nothinx/RECELL-AI/README.md

# 🔋 RECELL-AI

> **Mesin Klasifikasi Otomatis Baterai Bekas (*Second-Life*) Standar Industri**
> Sistem grading multimodal (Computer Vision + Time-Series Electrochemistry) untuk kompetisi **KIWIE 2026**.








---

## 🖥️ Tampilan Dashboard

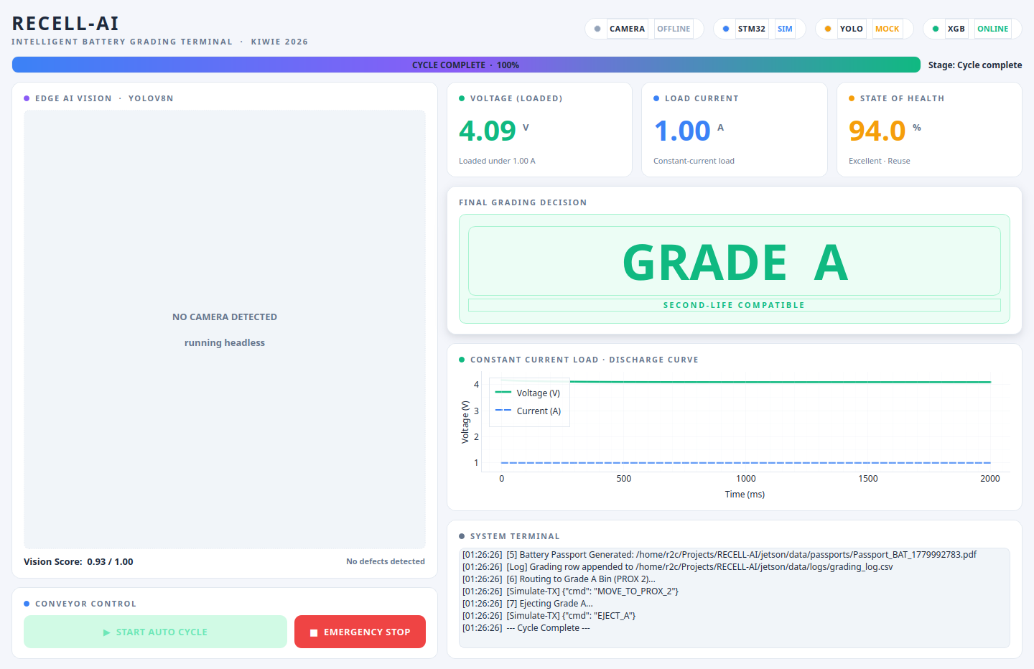
[picture p1: docs/images/dashboard_complete.png]
Dashboard — hasil cycle grading


<details>
<summary>Lihat state lain (STANDBY & TESTING)</summary>

| STANDBY (sebelum cycle) | TESTING (saat constant-current load) |
| :---: | :---: |
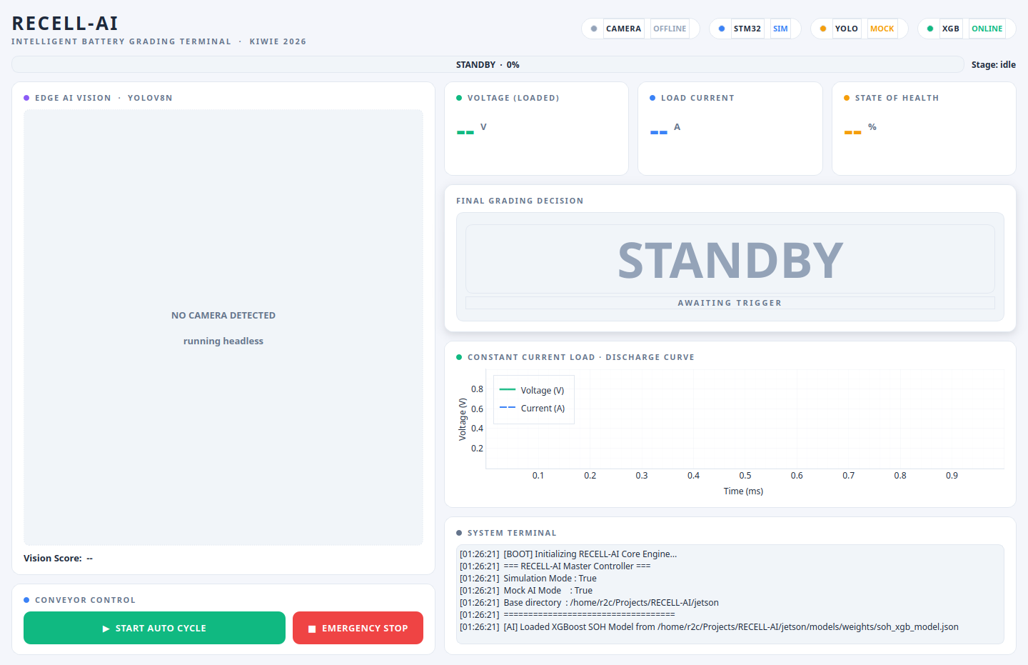
[picture p2: docs/images/dashboard_standby.png]
Standby
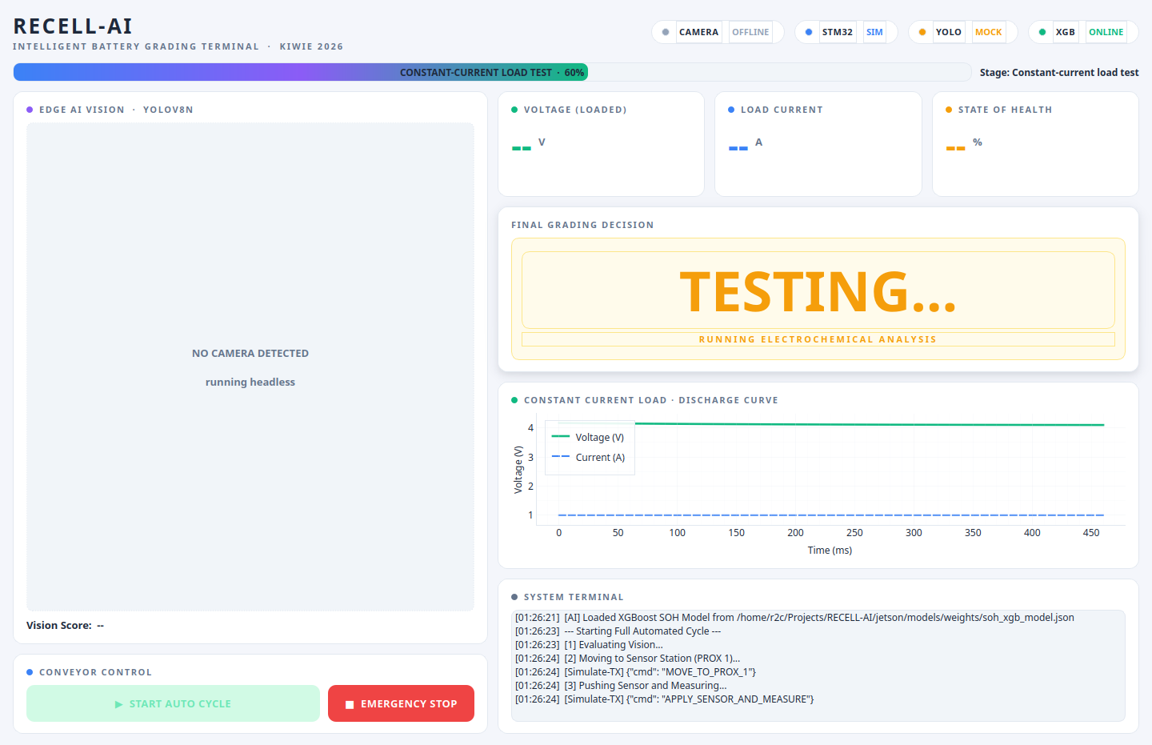
[picture p3: docs/images/dashboard_running.png]
Testing
|  |  |
</details>

---

## 📂 Struktur Workspace

| Modul | Deskripsi | Status |
| :--- | :--- | :--- |
| [**🧠 `jetson/`**](./jetson) | Otak AI multimodal (YOLOv8n + XGBoost), dashboard PyQt5, orkestrasi cycle | `Software siap` |
| [**👁️ `carollus/`**](./carollus) | Modul Computer Vision self-contained: classifier YOLOv8n-cls 4 kelas (KARAT/KOSONG/SEHAT/SOBEK) + skrip evaluasi/deploy | `Aktif` |
| [**🦾 `firmware/`**](./firmware) | Firmware STM32F411: ADC 12-bit, kontrol stepper & konveyor, payload JSON | `Siap di-flash` |
| [**🔬 `research/`**](./research) | Whitepaper, arsitektur AI, plot matplotlib untuk publikasi | `Aktif` |
| [**📖 `docs/`**](./docs) | Panduan deploy, cheatsheet rumus SoH, gambar dashboard | `Aktif` |

---

## 🧠 Arsitektur Multimodal

```
┌──────────────────┐     ┌──────────────────┐     ┌──────────────────┐
│ YOLOv8n-cls (Vis)│     │  XGBoost  (SOH)  │     │  STM32  (Sensor) │
│  best_cls.pt     │     │  soh_xgb.json    │     │  INA226+MLX90614 │
│ KOSONG / KARAT / │     │  v_drop, Rint, ΔT│     │  JSON @115200 8N1│
│ SEHAT / SOBEK    │     │                  │     │                  │
└────────┬─────────┘     └────────┬─────────┘     └────────┬─────────┘
         │                        │                        │
         ▼                        ▼                        ▼
        Vision Score         SoH Prediksi (%)        Telemetri Real-time
                  \           |           /
                   \          |          /
                    ▼         ▼         ▼
            ┌────────────────────────────────┐
            │   Grading Decision (A / B / R) │
            │   • Vision < 0.4 OR SOH < 60 → R│
            │   • Vision > 0.8 AND SOH > 80 → A│
            │   • selainnya → B               │
            └────────────────┬───────────────┘
                             ▼
            ┌────────────────────────────────┐
            │  Battery Passport (PDF + QR    │
            │  bertanda tangan HMAC-SHA256)  │
            │  grading_log.csv + discharge   │
            └────────────────────────────────┘
```

---

## 🚀 Quick Start

### 1. Install dependency
```bash
# Recommended (di Jetson Orin Nano): ikuti panduan resmi NVIDIA untuk torch + opencv
# Di PC dev (CPU-only):
pip install -r jetson/requirements.txt
pip install torch torchvision --index-url https://download.pytorch.org/whl/cpu
```

### 2. Pastikan model siap
```text
jetson/models/weights/
├── best_cls.pt          # YOLOv8n-cls (KOSONG / KARAT / SEHAT / SOBEK) — dipakai utama
├── best.pt              # YOLOv8n detect (fallback bila best_cls.pt tidak ada)
└── soh_xgb_model.json   # XGBoost SoH regressor (NASA-trained)
```

> `main.py` memilih model **classification** (`best_cls.*`) lebih dulu; deteksi objek (`best.*`) hanya fallback bila classifier tidak ada.

### 3. Jalankan dashboard
```bash
cd jetson/src

# Mode 1 — Sim + YOLO real + kamera laptop
python3 ui_dashboard.py --sim

# Mode 2 — Sim + tanpa YOLO/kamera (paling cepat, GUI saja)
python3 ui_dashboard.py --sim --mock-ai

# Mode 3 — Produksi (STM32 di /dev/ttyUSB0)
python3 ui_dashboard.py
```

### 4. (Jetson saja) Kompilasi YOLO ke TensorRT
```bash
# Di Jetson Orin Nano — 2× lebih cepat dengan FP16
yolo export model=jetson/models/weights/best_cls.pt format=engine half=True imgsz=224
# main.py akan otomatis prefer best_cls.engine di atas best_cls.pt
```

---

## 🔬 AI Vision Classes

Model **classifier** `best_cls.pt` (YOLOv8n-cls, 224×224) mengambil **Top-1** dari 4 kelas:

| Label | Arti | Vision Score | Catatan |
| :---: | :--- | :--- | :--- |
| **`KOSONG`** | Slot kosong / tak ada baterai | — (*gate*) | Frame diabaikan, bukan sinyal grading |
| **`SEHAT`** | Baterai bersih | `1.0` | Kandidat Grade A |
| **`KARAT`** | Korosi/karat di kutub | `0.5` | Dihitung setelah lolos persistence (≥ 3 frame) |
| **`SOBEK`** | Wrapper plastik sobek | `0.0` | Defect berat → cenderung Grade R |

> **Catatan** — Ini **klasifikasi citra**, bukan deteksi objek, jadi **tidak ada bounding box** di feed; model hanya menjawab kondisi dominan (Top-1) per frame. Defect (`KARAT`/`SOBEK`) baru dihitung setelah persisten ≥ 3 frame untuk menyaring false positive. Modul vision mandiri ada di [`carollus/`](./carollus).

---

## ⚡ AI Electrical (SoH)

XGBoost regressor dilatih pada **NASA Prognostics Battery Dataset**. Fitur input:

| Fitur | Sumber | Rentang Khas |
| :--- | :--- | :--- |
| `v_drop` (V) | `v_resting − v_loaded` | 0.05 – 0.50 |
| `internal_r` (Ω) | `v_drop / current_load` | 0.05 – 0.50 |
| `temp_delta` (°C) | `temp_post − temp_pre` | 0.5 – 8.0 |

Output: prediksi SoH (%) dengan clamp `[0, 100]`. Fallback rule-based aktif jika model gagal di-load.

---

## 🔌 Pinout Hardware (STM32F411CEU6)

### Aktuator & Konveyor (Motor Driver BTS7960)
| Pin | Fungsi | Deskripsi |
| :---: | :--- | :--- |
| `PA5` | `CONVEYOR_EN` | Enable BTS7960 |
| `PA1` | `CONVEYOR_RPWM` | PWM maju |
| `PA2` | `CONVEYOR_LPWM` | PWM mundur |
| `PB0` / `PB9` / `PA7` | `STP_DRAIN_*` | Stepper Drain Station (DIR/PUL/EN) |
| `PA3` / `PA8` / `PA6` | `STP_SORT_*` | Stepper Sorting Station (DIR/PUL/EN) |

### Sensor, Limit Switch & Pengukuran
| Pin | Fungsi | Deskripsi |
| :---: | :--- | :--- |
| `PB15` / `PA4` | `LIMIT_DRAIN` / `LIMIT_SORTING` | Batas mekanik stepper |
| `PB14` / `PB12` / `PB13` | `IR_DRAIN` / `IR_SORTING` / `IR_BACKUP` | Sensor IR baterai |
| `PB5` | `EMERGENCY` | Tombol Emergency Stop |
| `PB1` | `DAC_EN` | Enable Constant-Current Load (DAC MCP4725) |
| `PB7` / `PB6` | `I2C SDA` / `SCL` | Bus untuk INA226 (V/I), MLX90614 (suhu), MCP4725 (DAC) |

---

## 🔄 Cycle Otomatis (7 Langkah)

```
[1] Evaluasi Vision (capture frame, klasifikasi YOLO)
[2] Konveyor → PROX 1 (Sensor Station)
[3] Push sensor + Constant-Current Load Test (~2s discharge curve)
[4] Hitung Grade (A / B / R) dari vision_score + SoH
[5] Generate Battery Passport (PDF + QR bertanda tangan HMAC-SHA256)
[6] Routing:
    - Grade A → PROX 2 → Eject ke bin A
    - Grade B/R → END_OF_CONVEYOR → bin reject
[7] Cycle Complete + log CSV (grading_log + discharge_curve)
```

Emergency Stop dapat memutus cycle di langkah manapun (set `abort_cycle` flag, putus semua wait loop).

---

## 📊 Output Per Cycle

| File | Path | Isi |
| :--- | :--- | :--- |
| Battery Passport | `jetson/data/passports/Passport_<ID>.pdf` | Sertifikat per-baterai: ID, grade, foto, V/I/SoH + QR bertanda tangan HMAC-SHA256 |
| Grading log | `jetson/data/logs/grading_log.csv` | 1 baris per cycle: semua metrik agregat + ground truth |
| Discharge curve | `jetson/data/logs/discharge_curve.csv` | Time-series 20 ms cadence: t_ms, voltage, current, temp |

`battery_id` shared antar 3 file, jadi kurva discharge bisa di-join balik ke grade-nya untuk analisa offline.

---

## 🔐 Battery Passport Bertanda Tangan (Anti-Pemalsuan)

Setiap Battery Passport membawa **QR bertanda tangan kriptografis** agar sertifikat tidak bisa dipalsukan — semua **100% offline**, hanya memakai stdlib Python (`hmac`, `hashlib`, `secrets`), tanpa dependency berat.

**Cara kerja:**
1. Field uji disusun jadi payload kanonik berurutan tetap:
   `RC1|id|grade|soh|v_drop|internal_r|date` (presisi tiap field dikunci agar reproducible).
2. Payload ditandatangani **HMAC-SHA256** dengan kunci rahasia **per-alat**.
3. QR berisi `<payload>~<signature>`. Mengubah **satu field pun** membuat tanda tangan tidak cocok.

**Kunci penandatangan** (`jetson/config/passport_key.txt`):
- Auto-generate acak (64 hex) saat pertama kali dipakai, unik per unit.
- **RAHASIA** — sudah masuk `.gitignore`, jangan pernah di-commit. Backup terpisah.

**Verifikasi sebuah QR (offline):**
```bash
python jetson/scripts/verify_passport.py "<isi_string_QR>"
# → cetak VALID / INVALID + field terurai
# → exit code 0 (VALID) / 1 (INVALID) — gampang dipakai di skrip
```

Verifier tetap menampilkan isi yang *diklaim* meski tanda tangan gagal, sekaligus menandainya **INVALID** — jadi pemeriksa bisa lihat data palsunya.

> Modul: [`jetson/src/passport_auth.py`](./jetson/src/passport_auth.py) (sign/verify) · [`jetson/scripts/verify_passport.py`](./jetson/scripts/verify_passport.py) (CLI verifier)

---

## 🔁 Protokol Sinkronisasi Firmware ↔ GUI

Jetson dan STM32 bicara lewat **newline-delimited JSON** over USB-CDC @ **115200 8N1**. Kontrak ini bersifat **kanonik** — kedua sisi harus sepakat soal nama command, status, dan field. Sebuah regression test (`tests/test_protocol_sync.py`) memastikan tak ada satu sisi yang me-*rename* tanpa sisi lain ikut.

### Arah Jetson → STM32 (Command)
Paket dikirim `send_command(cmd, params)` → `{"cmd": "<NAMA>", ...params}\n`.

| Command | Aksi di STM32 |
| :--- | :--- |
| `RESET` | Homing semua stepper ke limit switch, reset state |
| `MOVE_TO_PROX_1` | Konveyor jalan sampai baterai di Sensor Station |
| `APPLY_SENSOR_AND_MEASURE` | Push probe + Constant-Current Load Test → stream kurva discharge |
| `MOVE_TO_PROX_2` | Konveyor jalan ke titik eject Grade A |
| `EJECT_A` | Stepper sorting dorong baterai ke bin A |
| `MOVE_TO_END` | Konveyor jalan ke ujung (bin reject B/R) |
| `STOP_CONVEYOR` | Hentikan konveyor |

### Arah STM32 → Jetson (Status)
Firmware memancarkan `{"status": "<NAMA>", ...field}\n`.

| Status | Dipakai Jetson? | Arti |
| :--- | :---: | :--- |
| `BOOT_OK` | — | Firmware siap setelah power-on |
| `AT_PROX_1` / `AT_PROX_2` | ✅ | Baterai sampai di Sensor / titik eject |
| `DISCHARGE_SAMPLE` | ✅ | Satu sampel kurva discharge (streaming ~20 ms) |
| `MEASUREMENT_DONE` | ✅ | Load test selesai, kirim agregat akhir |
| `EJECTED_A` / `DROPPED_B` | ✅ | Routing fisik selesai (bin A / bin reject) |
| `EMERGENCY_STOP` | ✅ | Tombol E-Stop ditekan → abort cycle |
| `STEP_TIMEOUT` | ✅ | Stepper tak capai limit dalam waktu wajar (fault) |
| `STOPPED` / `RESET_OK` | — | Ack untuk `STOP_CONVEYOR` / `RESET` |

### Skema Field JSON
| Pesan | Field |
| :--- | :--- |
| `MEASUREMENT_DONE` | `volt`, `curr`, `v_resting`, `temp_pre`, `temp_post`, `temp_delta` |
| `DISCHARGE_SAMPLE` | `t_ms`, `volt`, `curr`, `temp` |

> **Jaga kontrak tetap sinkron** — jalankan test sebelum mengubah protokol:
> ```bash
> python tests/test_protocol_sync.py     # tanpa pytest pun bisa (blok __main__)
> ```
> Test ini scan `RECELL_STM32.ino`, `main.py`, dan `ui_dashboard.py`; gagal kalau ada command/status/field yang tidak cocok di kedua sisi.

---

## 🛠️ Stack Teknologi

### 🖥️ Jetson Orin Nano
- **Python 3.10+**, **PyQt5** + **pyqtgraph** (HMI light theme yang dipoles)
- **YOLOv8n** (Ultralytics) → ekspor TensorRT FP16 untuk produksi
- **XGBoost** Regressor 2.x
- **FPDF** untuk Battery Passport, **SQLAlchemy/CSV** untuk log

### 🦾 STM32 BlackPill (F411CEU6)
- **Arduino IDE + STM32duino Core**
- ADC 12-bit native + **oversampling N=50** (noise reduction)
- USB-CDC Serial @ **115200 8N1**, payload JSON

---

## 🧪 Status Verifikasi

| Komponen | Bisa diuji tanpa hardware? | Status |
| :--- | :---: | :--- |
| Dashboard GUI (semua state) | ✅ | Terverifikasi via smoke-test 3-stage |
| YOLO load + inferensi webcam | ✅ | Terverifikasi (classify 4 kelas: KOSONG/KARAT/SEHAT/SOBEK) |
| XGBoost SoH prediksi | ⚠️ | Load OK, akurasi perlu validasi pada baterai nyata |
| Battery Passport PDF | ✅ | PDF tergenerasi end-to-end |
| Tanda tangan & verifikasi QR passport | ✅ | Sign/verify HMAC-SHA256 ter-cover unit test (`tests/test_passport_auth.py`) |
| CSV grading + discharge log | ✅ | Schema lengkap, sample tersimpan benar |
| Emergency Stop full abort | ⚠️ | Logic ada, validasi di lab dengan STM32 |
| Komunikasi serial STM32 | ❌ | Butuh hardware |
| Konveyor + stepper motor | ❌ | Butuh hardware |
| Persistence threshold defects | ⚠️ | Logic ada, validasi dengan kamera + baterai nyata |

---

## 📚 Dokumentasi Tambahan

- 📖 [**DEPLOY_GUIDE_RECELL**](./docs/DEPLOY_GUIDE_RECELL.md) — Setup Jetson, flash STM32, SSH
- 📐 [**Cheatsheet Rumus SOH**](./docs/Cheatsheet_Rumus_SOH.md) — Penjabaran algoritma elektrokimia
- 🤖 [**AI Training Guideline**](./jetson/AI_TRAINING_GUIDELINE.md) — Pipeline training YOLO + XGBoost
- 🗂️ [**KONTEKS.md**](./KONTEKS.md) — Master AI handover document

---

## 👨‍💻 Tim

**Amadeo Wisesa** — *System Architect & AI Engineer*

> Dikembangkan untuk RECELL-AI · KIWIE 2026 Edition · Indonesia 🇮🇩
