nothinx/RECELL-AI/research/paper_visuals/poster_data/discharge_curve.csv

battery_id | t_ms | voltage | current | temp
BAT_001 | 0 | 4.0976 | 1.006 | 24.45
BAT_001 | 20 | 4.0914 | 0.9977 | 24.42
BAT_001 | 40 | 4.0811 | 0.9986 | 24.44
BAT_001 | 60 | 4.0752 | 1.0063 | 24.5
BAT_001 | 80 | 4.0703 | 0.9937 | 24.45
BAT_001 | 100 | 4.0605 | 0.9972 | 24.53
BAT_001 | 120 | 4.0599 | 1.0009 | 24.51
BAT_001 | 140 | 4.0532 | 0.9937 | 24.46
BAT_001 | 160 | 4.0482 | 0.9915 | 24.5
BAT_001 | 180 | 4.0417 | 1.0024 | 24.5
BAT_001 | 200 | 4.0439 | 1.0037 | 24.61
BAT_001 | 220 | 4.0412 | 1.0021 | 24.5
BAT_001 | 240 | 4.037 | 0.9935 | 24.58
BAT_001 | 260 | 4.0366 | 1.0027 | 24.59
BAT_001 | 280 | 4.0337 | 1.0048 | 24.55
BAT_001 | 300 | 4.0309 | 0.9995 | 24.5
BAT_001 | 320 | 4.027 | 1.0019 | 24.56
BAT_001 | 340 | 4.0252 | 1.0047 | 24.61
BAT_001 | 360 | 4.0243 | 1.0033 | 24.64
BAT_001 | 380 | 4.0233 | 0.9983 | 24.62
BAT_001 | 400 | 4.0206 | 0.9933 | 24.6
BAT_001 | 420 | 4.0181 | 1.0027 | 24.68
BAT_001 | 440 | 4.0189 | 1.0044 | 24.64
BAT_001 | 460 | 4.0173 | 0.9963 | 24.68
BAT_001 | 480 | 4.0198 | 0.9996 | 24.63
BAT_001 | 500 | 4.0194 | 0.9971 | 24.72
BAT_001 | 520 | 4.0184 | 0.9995 | 24.73
BAT_001 | 540 | 4.0137 | 1.0027 | 24.67
BAT_001 | 560 | 4.0097 | 0.998 | 24.68
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
