nothinx/RECELL-AI/research/paper_visuals/poster_data/grading_log.csv

timestamp | battery_id | cycle_time_s | v_resting | v_loaded | v_drop | current_load | internal_r | temp_pre | temp_post | temp_delta | soh_predicted | vision_score | defects_detected | grade_predicted | grade_ground_truth | passport_pdf
2026-05-28T09:00:00 | BAT_001 | 20.98 | 4.0969 | 4.0126 | 0.0843 | 1.0 | 0.0843 | 24.43 | 25.48 | 1.05 | 80.47 | 0.881 | none | A | A | data/passports/BAT_001.pdf
2026-05-28T09:00:22 | BAT_002 | 18.79 | 4.1147 | 4.035 | 0.0797 | 1.0 | 0.0797 | 24.04 | 24.93 | 0.89 | 87.21 | 0.803 | none | A | A | data/passports/BAT_002.pdf
2026-05-28T09:00:44 | BAT_003 | 20.41 | 4.101 | 3.9879 | 0.1132 | 1.0 | 0.1132 | 24.62 | 25.96 | 1.34 | 79.44 | 0.572 | dent | B | B | data/passports/BAT_003.pdf
2026-05-28T09:01:06 | BAT_004 | 20.12 | 4.1124 | 3.9838 | 0.1285 | 1.0 | 0.1285 | 25.13 | 26.2 | 1.07 | 84.41 | 0.748 | rust | B | B | data/passports/BAT_004.pdf
2026-05-28T09:01:28 | BAT_005 | 19.43 | 3.9883 | 3.7665 | 0.2218 | 1.0 | 0.2218 | 25.78 | 28.15 | 2.37 | 54.65 | 0.306 | rust | R | R | data/passports/BAT_005.pdf
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
