nothinx/RECELL-AI/carollus/sample_images/KARAT_sample.jpg

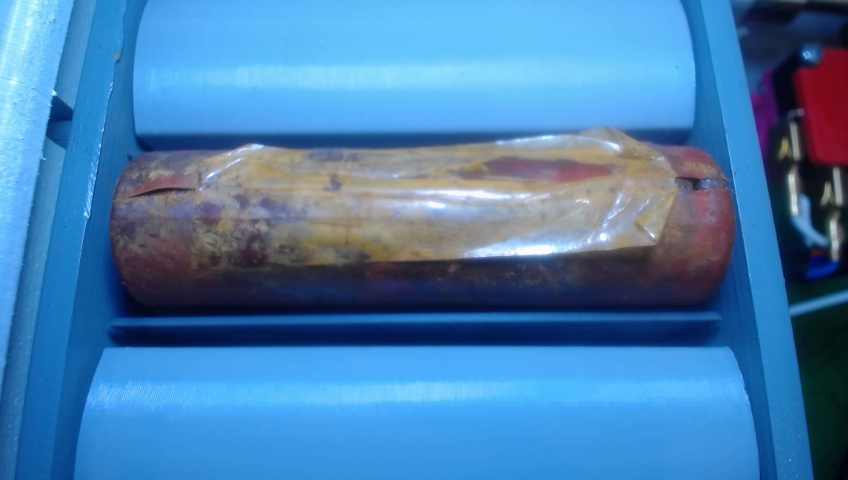
carollus/sample_images/KARAT_sample.jpg
