nothinx/RECELL-AI/carollus/sample_images/KOSONG_sample.jpg

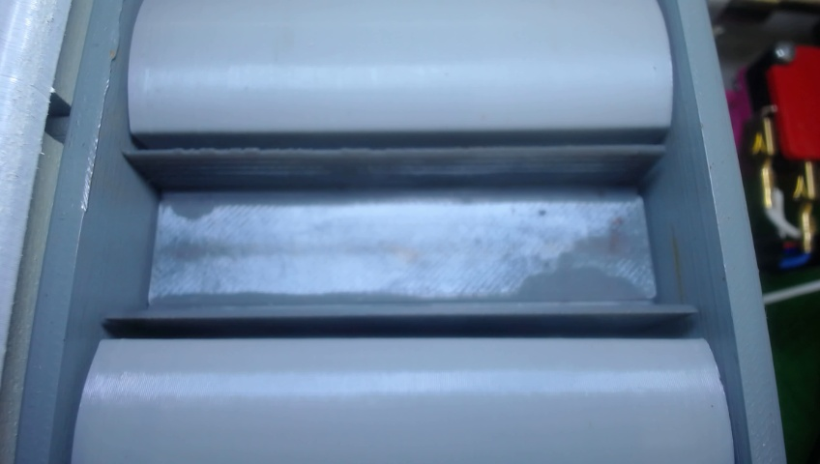
carollus/sample_images/KOSONG_sample.jpg
