nothinx/RECELL-AI/carollus/sample_images/SOBEK_sample.jpg

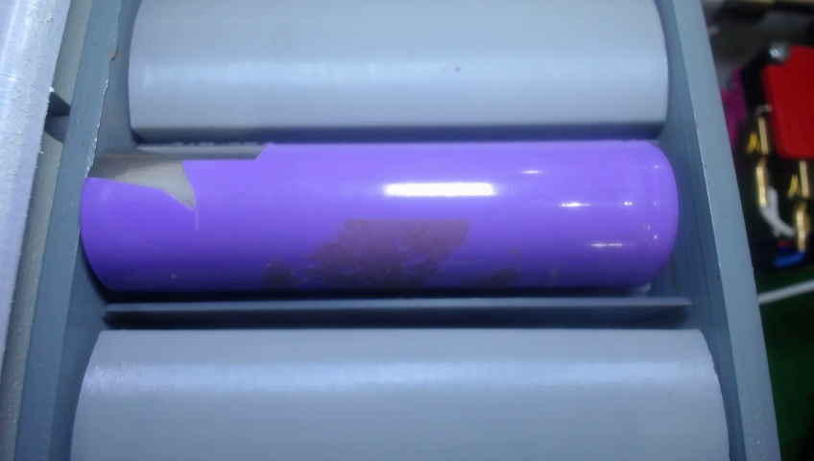
carollus/sample_images/SOBEK_sample.jpg
