nothinx/RECELL-AI/research/paper_visuals/output/01_grade_distribution.png

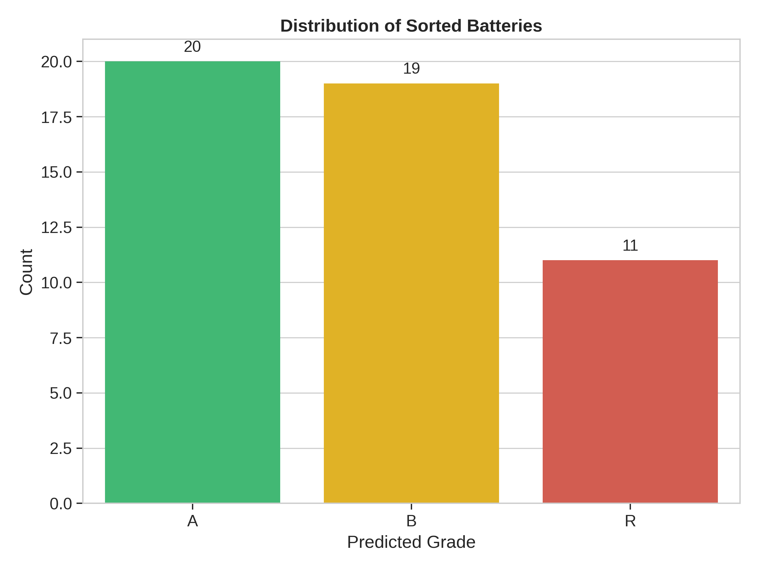
research/paper_visuals/output/01_grade_distribution.png
