nothinx/RECELL-AI/research/paper_visuals/output/02_ai_fusion_scatter.png

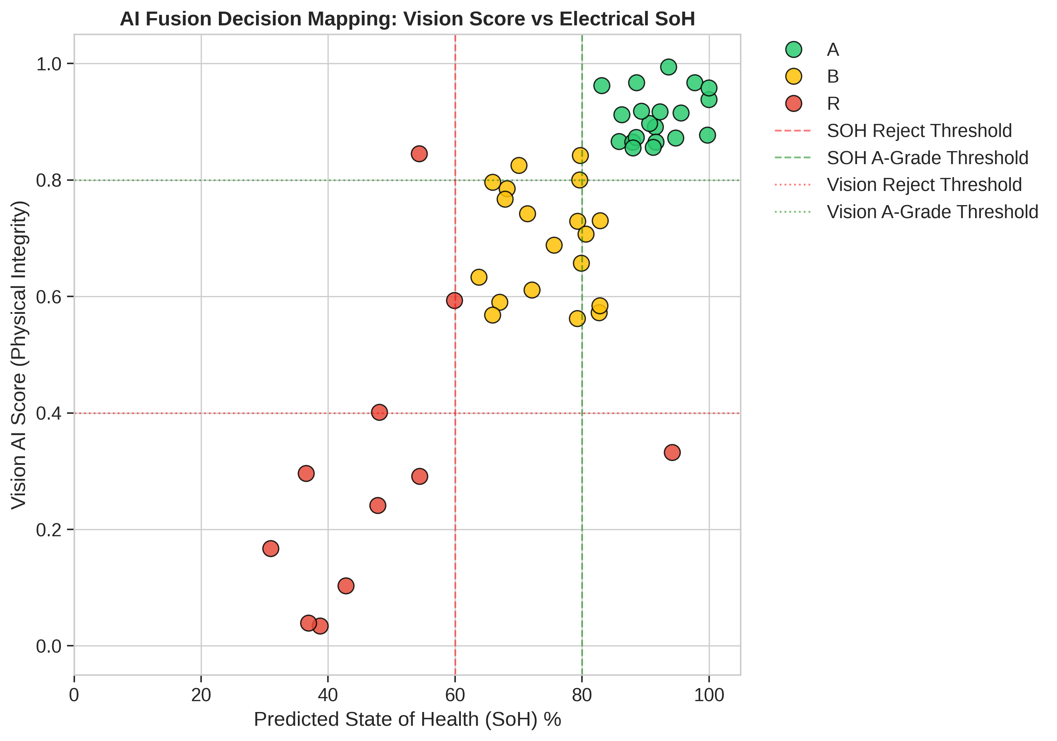
research/paper_visuals/output/02_ai_fusion_scatter.png
