nothinx/RECELL-AI/research/paper_visuals/output/03_discharge_curve.png

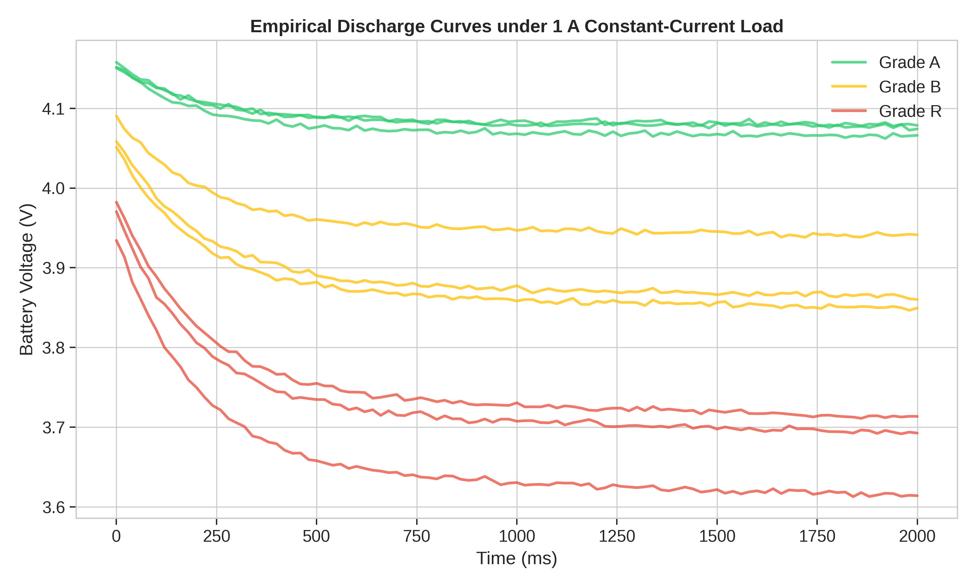
research/paper_visuals/output/03_discharge_curve.png
