nothinx/RECELL-AI/research/paper_visuals/output/04_confusion_matrix.png

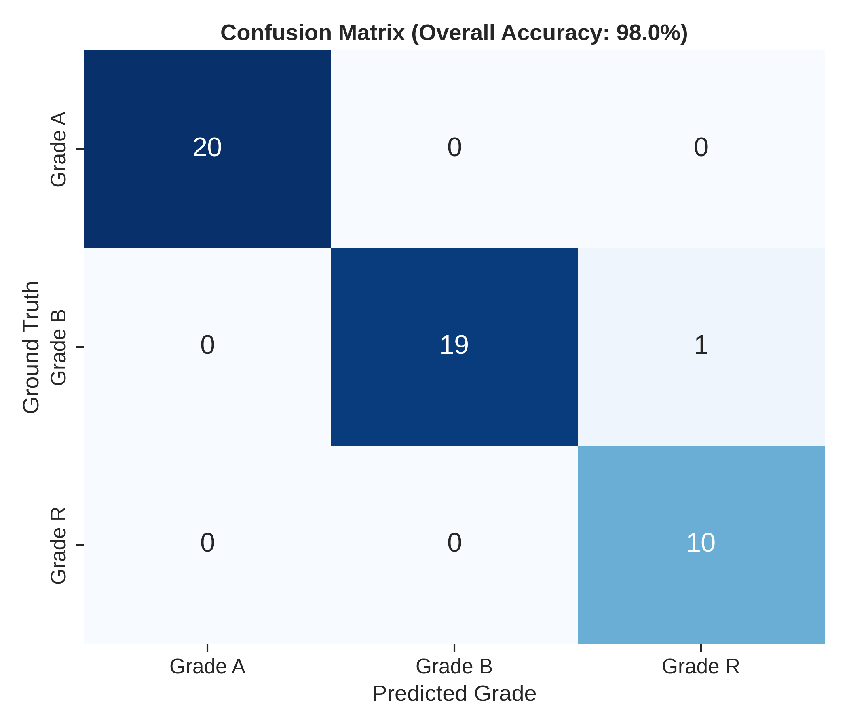
research/paper_visuals/output/04_confusion_matrix.png
