nothinx/RECELL-AI/research/paper_visuals/output/05_soh_distribution.png

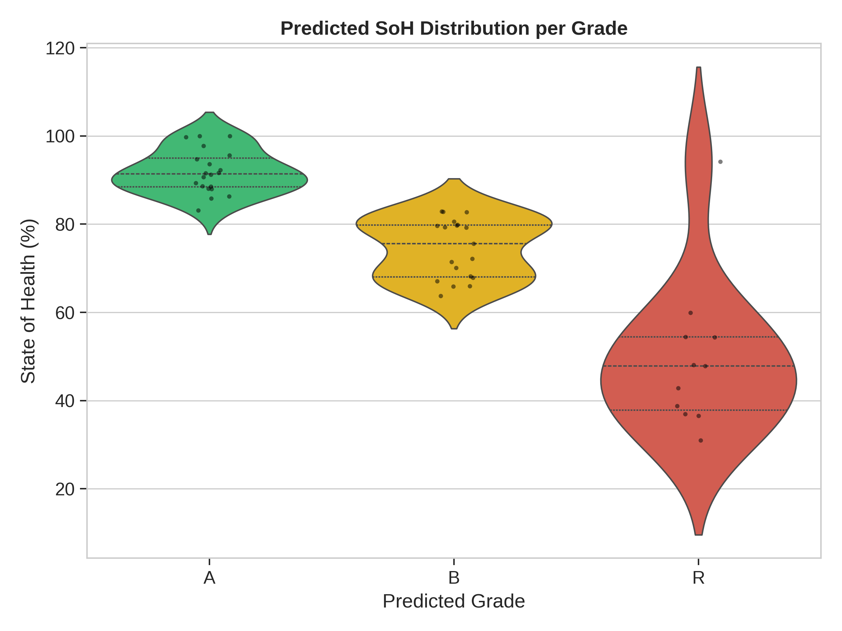
research/paper_visuals/output/05_soh_distribution.png
