nothinx/RECELL-AI/WhatsApp Image 2026-05-22 at 21.10.31.jpeg

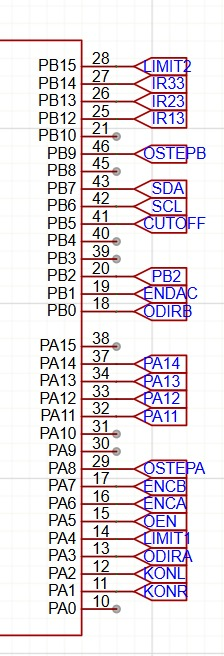
WhatsApp Image 2026-05-22 at 21.10.31.jpeg
