nothinx/RECELL-AI/jetson/src/main.py

import cv2
import serial
import threading
import time
import json
import argparse
import sys
import os
import subprocess
from pathlib import Path
try:
    import xgboost as xgb
    _HAS_XGBOOST = True
except ImportError:
    xgb = None
    _HAS_XGBOOST = False
import pandas as pd
from collections import defaultdict

from passport_generator import BatteryPassport
from data_logger import DataLogger

# Anchor every path to the jetson/ directory so we can run from anywhere.
BASE_DIR = Path(__file__).resolve().parent.parent
MODELS_DIR = BASE_DIR / "models"
DATA_DIR = BASE_DIR / "data"
PASSPORT_DIR = DATA_DIR / "passports"
LOG_DIR = DATA_DIR / "logs"

# Default Configuration
# STM32 ber-USB CDC ('Serial') enumerasi sebagai /dev/ttyACM0 di Jetson, BUKAN
# ttyUSB0 (itu untuk adapter FTDI/CH340). _pick_serial_port() auto-deteksi.
SERIAL_PORT = '/dev/ttyACM0'
SERIAL_FALLBACKS = ['/dev/ttyACM0', '/dev/ttyACM1', '/dev/ttyUSB0', '/dev/ttyUSB1']
BAUD_RATE = 115200

# Vision realtime tuning. imgsz kecil = jauh lebih ringan/cepat di Jetson untuk
# model .pt (untuk .engine ukuran sudah fix saat export). Naikkan bila akurasi
# kurang, turunkan bila masih berat.
YOLO_IMGSZ = 320
YOLO_CONF = 0.25

# Batas laju kirim frame ke UI. Inferensi TensorRT bisa ~70 fps; tanpa rem ini,
# camera loop membanjiri thread GUI (tiap frame discale SmoothTransformation) →
# antrian signal Qt menumpuk tak terbatas → seluruh UI beku/tombol tak bisa
# dipencet. 20 fps lebih dari cukup untuk preview; inferensi & latest_frame tetap
# jalan penuh. ponytail: cara "benar" = UI tarik latest_frame via QTimer; throttle
# di produsen ini lebih kecil dan sudah cukup.
UI_FRAME_INTERVAL = 1.0 / 20  # detik

# Kamera (Logitech C930e: sensor 16:9). Minta 4:3 (640x480) bikin driver crop
# sisi kiri-kanan → FOV menyempit & tampak "zoom". Pakai 16:9 untuk FOV penuh.
# 848x480 dipilih (bukan 720p): FOV sama penuhnya tapi beban ~setara 640x480 —
# 720p bikin scaling pixmap per-frame di thread GUI kelebihan beban → tombol UI
# tak responsif (YOLO toh downscale ke imgsz=320, jadi 720p sia-sia).
# ponytail: kalau butuh display lebih tajam, naikkan res + decouple laju display
# dari inferensi (emit tiap N frame), jangan sekadar gedein resolusi.
# Autofocus kontinu terus "hunting" di atas konveyor → matikan & kunci fokus.
# CAM_FOCUS tergantung jarak kamera→konveyor, tune live:
#   v4l2-ctl -d /dev/video0 -c focus_automatic_continuous=0 -c focus_absolute=NNN
CAM_WIDTH = int(os.environ.get("CAM_WIDTH", 848))
CAM_HEIGHT = int(os.environ.get("CAM_HEIGHT", 480))
CAM_FOCUS = int(os.environ.get("CAM_FOCUS", 115))  # 0-255 step 5; -1 = biarkan autofocus
YOLO_ENGINE_PATH = MODELS_DIR / "weights" / "best.engine"   # preferred on Jetson
YOLO_PT_PATH = MODELS_DIR / "weights" / "best.pt"           # fallback (dev / non-Jetson)
# Model CLASSIFICATION (kondisi baterai) — diutamakan bila ada. Kelas termasuk
# KOSONG (belt kosong) → kehadiran ditangani model, bukan IR (tak ada IR di bawah
# kamera). Lihat docs: pivot detection→classification 2026-06-24.
YOLO_CLS_ENGINE_PATH = MODELS_DIR / "weights" / "best_cls.engine"
YOLO_CLS_PT_PATH     = MODELS_DIR / "weights" / "best_cls.pt"
YOLO_CLS_IMGSZ = 224
EMPTY_CLASS = "KOSONG"                                       # kelas "tak ada baterai"
CLS_SCORE = {"SEHAT": 1.0, "KARAT": 0.5, "SOBEK": 0.0}      # → vision_score (calculate_final_grade)
CLS_CONF = 0.50                                             # ambang confidence agar dipercaya
XGB_MODEL_PATH = MODELS_DIR / "weights" / "soh_xgb_model.json"
CALIB_PATH = BASE_DIR / "calibration.json"

# Hardware motion defaults. Conveyor lowered after the trial showed it
# over-shooting the IR sensor even at PWM 30. Tune live via the F12 / on-screen
# calibration panel; values persist to calibration.json and are pushed to the
# STM32 on every connect.
# Keys match the STM32 SET_CONFIG parser exactly (sent verbatim as the payload).
DEFAULT_CALIBRATION = {
    "conveyor_speed": 25,    # PWM 0-255
    "step_pulse_us": 50,     # stepper half-pulse target (us)
    "ramp_start_us": 600,    # stepper accel ramp: slow start half-pulse (us)
    "ramp_steps": 300,       # ramp length (steps) to reach target
    "dac_load": 4095,        # measurement DAC load 0-4095
    "discharge_samples": 40, # discharge curve samples
    "discharge_period": 50,  # ms per discharge sample
    "ir2_settle": 0,         # ms conveyor runs past IR2 before stopping
}
# Per-field clamp ranges (must mirror firmware constrain()).
CALIB_RANGES = {
    "conveyor_speed": (0, 255), "step_pulse_us": (20, 5000),
    "ramp_start_us": (20, 5000), "ramp_steps": (0, 5000),
    "dac_load": (0, 4095), "discharge_samples": (1, 500),
    "discharge_period": (5, 1000), "ir2_settle": (0, 5000),
}

# Map YOLO class label -> (delta to vision_score, is_critical)
# Classes from best.pt: KARAT (rust), SEHAT (healthy), SOBEK (torn wrapper)
CLASS_RULES = {
    "KARAT":  {"delta": -0.4, "critical": False},
    "SOBEK":  {"delta": 0.0,  "critical": True},   # any SOBEK -> reject
    "SEHAT":  {"delta": 0.0,  "critical": False},  # neutral positive
}

# A defect class must be detected in at least this many *frames* during a
# cycle before it counts toward the grade. Filters transient false positives.
DEFECT_PERSIST_FRAMES = 3

# Berapa frame beruntun harus ada deteksi (kelas apa pun) sebelum dianggap ada
# baterai di bawah kamera. Dipakai vision-gated cycle untuk memicu stop inspeksi.
BATTERY_PRESENT_FRAMES = 3


class RecellMaster:
    def __init__(self, simulate=False, mock_ai=False, ui_callbacks=None):
        self.simulate = simulate
        # True jika hardware serial DIMAKSUDKAN ada (bukan --sim). Watchdog hanya
        # mencoba reconnect bila ini True — agar mode simulasi sengaja tak diganggu.
        self._serial_intended = not simulate
        self._last_rx = time.time()   # waktu RX terakhir (utk deteksi board hang)
        self.mock_ai = mock_ai
        self.running = True
        self.ser = None
        self.passport_gen = BatteryPassport(output_dir=str(PASSPORT_DIR))
        self.logger = DataLogger(output_dir=str(LOG_DIR))

        # Hardware/AI status (consumed by UI status indicators)
        self.status = {
            "camera": "offline",   # offline | online | mock
            "serial": "offline",   # offline | online | sim
            "yolo":   "offline",   # offline | online | mock
            "xgb":    "offline",   # offline | online | rule
        }

        self.grade_decision = None
        self.vision_score = 1.0
        self.electrical_data = {"soh": 0, "volt": 0, "curr": 0}
        self.latest_frame = None
        self._last_ui_emit = 0.0  # throttle frame push to UI (lihat UI_FRAME_INTERVAL)
        # Deteksi kehadiran baterai di bawah kamera (hulu) untuk vision-gated cycle.
        self.battery_in_view = False
        self._cls_label = None      # kelas classification dominan (selain KOSONG)
        self._battery_frames = 0
        self.current_battery_id = None
        # Count how many frames in the current cycle saw each label, so a
        # single false-positive frame doesn't permanently mark a defect.
        self.defect_frame_counts = defaultdict(int)
        self.measurement_detail = {}

        # UI Callbacks
        self.ui_callbacks = ui_callbacks or {}
        self.wait_flag = False
        self.abort_cycle = False  # set by Emergency Stop, breaks _simulate_measurement

        self._serial_lock = threading.Lock()        # #5: guard serial r/w across threads
        self._camera_restart_requested = False      # #8: set by restart_camera()
        self.calibration = self._load_calibration()

        self.log_msg("=== RECELL-AI Master Controller ===")
        self.log_msg(f"Simulation Mode : {self.simulate}")
        self.log_msg(f"Mock AI Mode    : {self.mock_ai}")
        self.log_msg(f"Base directory  : {BASE_DIR}")
        self.log_msg("===================================")

        # Initialize Vision (YOLO)
        self.model = None
        self.is_cls = False                 # True bila model classification
        self.imgsz = YOLO_IMGSZ
        if not self.mock_ai:
            # Matikan telemetry/sync SEBELUM init — mencegah HTTP call di Jetson air-gapped.
            # setup.sh sudah mempersistnya ke ~/.config/Ultralytics/settings.yaml, tapi
            # ini adalah fallback agar efektif bahkan saat dijalankan di laptop dev.
            try:
                from ultralytics import settings as _uly
                _uly.update({"sync": False})
            except Exception:
                pass
            try:
                from ultralytics import YOLO
                if YOLO_CLS_ENGINE_PATH.exists():
                    self.log_msg(f"[AI] Loading TensorRT CLASSIFY engine: {YOLO_CLS_ENGINE_PATH}")
                    self.model = YOLO(str(YOLO_CLS_ENGINE_PATH), task="classify")
                    self.is_cls = True
                elif YOLO_CLS_PT_PATH.exists():
                    self.log_msg(f"[AI] Loading PyTorch CLASSIFY model: {YOLO_CLS_PT_PATH}")
                    self.model = YOLO(str(YOLO_CLS_PT_PATH))
                    self.is_cls = True
                elif YOLO_ENGINE_PATH.exists():
                    self.log_msg(f"[AI] Loading TensorRT detect engine: {YOLO_ENGINE_PATH}")
                    self.model = YOLO(str(YOLO_ENGINE_PATH), task="detect")
                elif YOLO_PT_PATH.exists():
                    self.log_msg(f"[AI] Loading PyTorch model: {YOLO_PT_PATH}")
                    self.model = YOLO(str(YOLO_PT_PATH))
                    self.is_cls = (getattr(self.model, "task", "") == "classify")
                else:
                    raise FileNotFoundError(
                        f"No model found at {YOLO_CLS_PT_PATH} / {YOLO_PT_PATH}"
                    )
                self.imgsz = YOLO_CLS_IMGSZ if self.is_cls else YOLO_IMGSZ
                self.log_msg(f"[AI] mode={'CLASSIFY' if self.is_cls else 'DETECT'} "
                             f"imgsz={self.imgsz} classes={self.model.names}")
                self.status["yolo"] = "online"
            except Exception as e:
                self.log_msg(f"[AI] Failed to load YOLO ({e}). Falling back to MOCK_AI.")
                self.mock_ai = True
                self.status["yolo"] = "mock"
        else:
            self.status["yolo"] = "mock"

        # Initialize Electrical SOH AI (XGBoost). The package itself is optional:
        # on a dev box without xgboost installed the app still runs end-to-end
        # with rule-based SOH instead of crashing at import.
        self.xgb_model = None
        if not _HAS_XGBOOST:
            self.log_msg("[AI] xgboost not installed — using hardcoded SOH rules.")
            self.has_xgb = False
            self.status["xgb"] = "rule"
        else:
            self.xgb_model = xgb.XGBRegressor()
            try:
                self.xgb_model.load_model(str(XGB_MODEL_PATH))
                self.log_msg(f"[AI] Loaded XGBoost SOH Model from {XGB_MODEL_PATH}")
                self.has_xgb = True
                self.status["xgb"] = "online"
            except Exception as e:
                self.log_msg(f"[AI] Failed to load XGBoost: {e}. Will use hardcoded SOH rules.")
                self.has_xgb = False
                self.status["xgb"] = "rule"

        if not self.simulate:
            try:
                port = self._pick_serial_port()
                self.ser = serial.Serial(port, BAUD_RATE, timeout=0.1)
                self.log_msg(f"[Comm] Connected to STM32 on {port}")
                self.status["serial"] = "online"
                time.sleep(2)  # let the board finish booting before config
                # Safety: pastikan konveyor berhenti saat (re)connect — kalau STM32
                # sebelumnya ditinggal jalan (mis. crash/restart Jetson), ini
                # membawanya ke keadaan diam yang pasti.
                self.send_command("STOP_CONVEYOR")
                self.send_command("SET_CONFIG", self.calibration)
                self.log_msg(f"[Comm] Pushed calibration: {self.calibration}")
            except Exception as e:
                self.log_msg(f"[Comm] Error connecting to Serial: {e}. Falling back to SIMULATION.")
                self.simulate = True
                self.status["serial"] = "sim"
        else:
            self.status["serial"] = "sim"

        self._notify_status()

    def _notify_status(self):
        if "on_status" in self.ui_callbacks:
            self.ui_callbacks["on_status"](dict(self.status))

    @staticmethod
    def list_serial_ports():
        """Return list of (port, description) for all detected serial devices."""
        from serial.tools import list_ports
        return [(p.device, p.description) for p in list_ports.comports()]

    def _pick_serial_port(self):
        """Pilih port STM32: utamakan ACM* yang benar-benar ada, lalu USB*."""
        available = [dev for dev, _ in self.list_serial_ports()]
        for cand in SERIAL_FALLBACKS:
            if cand in available:
                return cand
        # ACM apa pun dulu (STM32 CDC), baru USB, baru default.
        for dev in available:
            if "ACM" in dev:
                return dev
        return available[0] if available else SERIAL_PORT

    def reconnect_serial(self, port, baud=115200):
        """Close existing serial connection and open a new one on *port*."""
        with self._serial_lock:
            if self.ser and self.ser.is_open:
                try:
                    self.ser.close()
                except Exception:
                    pass
            self.ser = None
            try:
                self.ser = serial.Serial(port, baud, timeout=0.1)
                self.simulate = False
                self.status["serial"] = "online"
                self.log_msg(f"[Comm] Reconnected to STM32 on {port} @ {baud} baud")
            except Exception as e:
                self.simulate = True
                self.status["serial"] = "offline"
                self.log_msg(f"[Comm] Failed to connect to {port}: {e}")
        # Push calibration outside the lock (send_command re-acquires it).
        if self.status["serial"] == "online":
            self.send_command("SET_CONFIG", self.calibration)
        self._notify_status()
        return self.status["serial"] == "online"

    def disconnect_serial(self):
        """Close serial port and switch to simulation mode."""
        with self._serial_lock:
            if self.ser and self.ser.is_open:
                try:
                    self.ser.close()
                except Exception:
                    pass
            self.ser = None
        self.simulate = True
        self.status["serial"] = "sim"
        self.log_msg("[Comm] Serial disconnected — simulation mode active")
        self._notify_status()

    def restart_camera(self):
        """Minta vision_thread untuk menutup dan membuka ulang kamera."""
        self._camera_restart_requested = True
        self.status["camera"] = "offline"
        self._notify_status()
        self.log_msg("[Camera] Restart diminta…")

    def override_grade(self, new_grade):
        """Override keputusan AI dengan grade manual dari operator."""
        old = self.grade_decision
        self.grade_decision = new_grade
        self.log_msg(f"[Override] Grade diubah: {old} → {new_grade} (manual operator)")
        self.trigger_telemetry_update()

    def log_msg(self, msg):
        print(msg)
        if 'on_log' in self.ui_callbacks:
            self.ui_callbacks['on_log'](msg)

    def vision_thread(self):
        """Loop utama kamera — restart otomatis jika restart_camera() dipanggil."""
        while self.running:
            self._camera_restart_requested = False
            self._run_camera_session()
            # Keluar loop hanya jika running=False (shutdown) atau restart diminta
            if not self._camera_restart_requested:
                break

    def _lock_focus(self):
        """Matikan autofocus kontinu & kunci fokus di CAM_FOCUS. Dipanggil setelah
        stream jalan (C930e abaikan set fokus saat open). LC_ALL=C: di bawah systemd
        locale kosong bikin v4l2-ctl gagal parse arg. Dua panggilan terpisah lebih
        andal dari satu gabungan. CAM_FOCUS<0 = biarkan autofocus."""
        if CAM_FOCUS < 0:
            return
        env = {**os.environ, "LC_ALL": "C", "LANG": "C"}
        try:
            for ctrl in (f"focus_automatic_continuous=0", f"focus_absolute={CAM_FOCUS}"):
                r = subprocess.run(
                    ["v4l2-ctl", "-d", "/dev/video0", "-c", ctrl],
                    check=False, timeout=2, env=env,
                    capture_output=True, text=True,
                )
                if r.returncode != 0:
                    self.log_msg(f"[Camera] set fokus '{ctrl}' gagal: {r.stderr.strip()}")
            self.log_msg(f"[Camera] Fokus dikunci (focus_absolute={CAM_FOCUS}, autofocus off).")
        except (FileNotFoundError, subprocess.SubprocessError):
            self.log_msg("[Camera] v4l2-ctl tak ada; fokus tetap auto (pasang v4l-utils).")

    def _run_camera_session(self):
        """Satu sesi kamera: buka, inferensi, tutup. Bisa diulang oleh vision_thread."""
        if self.mock_ai:
            while self.running and not self._camera_restart_requested:
                time.sleep(0.5)
            return

        cap = cv2.VideoCapture(0)
        if not cap.isOpened():
            self.log_msg("[Camera] Tidak ada kamera (VideoCapture(0) gagal). Mode MOCK.")
            self.status["camera"] = "mock"
            self._notify_status()
            cap.release()
            while self.running and not self._camera_restart_requested:
                time.sleep(0.5)
            return

        # Realtime: buffer 1 frame agar tidak menampilkan frame lama (sumber utama
        # rasa "delay"); turunkan resolusi capture agar ringan.
        cap.set(cv2.CAP_PROP_BUFFERSIZE, 1)
        # MJPG dulu baru resolusi (urutan penting untuk 720p@30 di USB2).
        cap.set(cv2.CAP_PROP_FOURCC, cv2.VideoWriter_fourcc(*"MJPG"))
        cap.set(cv2.CAP_PROP_FRAME_WIDTH, CAM_WIDTH)
        cap.set(cv2.CAP_PROP_FRAME_HEIGHT, CAM_HEIGHT)
        self.status["camera"] = "online"
        self._notify_status()
        self.log_msg(f"[Camera] Kamera aktif, inferensi YOLO (imgsz={self.imgsz}, "
                     f"mode={'CLS' if self.is_cls else 'DET'}).")

        focus_locked = False  # kunci fokus SETELAH stream jalan (lihat _lock_focus)
        try:
            while self.running and not self._camera_restart_requested:
                ret, frame = cap.read()
                if not ret:
                    time.sleep(0.05)
                    continue
                if not focus_locked:
                    # C930e tak menerima set fokus saat open (sebelum streaming);
                    # baru nempel setelah ada frame. Jadi terapkan sekali di sini.
                    self._lock_focus()
                    focus_locked = True
                try:
                    results = self.model(frame, imgsz=self.imgsz, conf=YOLO_CONF, verbose=False)
                    annotated_frame = results[0].plot()
                    self.latest_frame = annotated_frame.copy()
                    # Throttle ke UI agar thread GUI tidak kebanjiran (lihat
                    # UI_FRAME_INTERVAL). latest_frame tetap update tiap frame.
                    now = time.time()
                    if ('on_frame' in self.ui_callbacks
                            and now - self._last_ui_emit >= UI_FRAME_INTERVAL):
                        self._last_ui_emit = now
                        self.ui_callbacks['on_frame'](annotated_frame)
                    self.process_ai_results(results)
                except Exception as e:
                    self.log_msg(f"[Vision] inference error: {e}")
                    time.sleep(0.1)
                # Tanpa FPS cap buatan: inferensi sendiri yang menentukan laju.
                # Yield singkat agar core tidak 100% saat inferensi sangat cepat.
                time.sleep(0.001)
        finally:
            cap.release()
            if self._camera_restart_requested:
                self.log_msg("[Camera] Sesi ditutup, membuka ulang…")
                time.sleep(1)

    def process_ai_results(self, results):
        if self.is_cls:
            self._process_cls(results)
            return
        # ---- DETECTION (model lama, fallback) ----
        # Count each label at most once per frame: many boxes of the same
        # class shouldn't multiply the penalty.
        labels_this_frame = set()
        for r in results:
            for box in r.boxes:
                cls_id = int(box.cls[0])
                labels_this_frame.add(self.model.names[cls_id])
        for label in labels_this_frame:
            self.defect_frame_counts[label] += 1

        # Kehadiran baterai di bawah kamera: deteksi kelas apa pun (SEHAT/KARAT/
        # SOBEK = ada baterai). Persistensi BATTERY_PRESENT_FRAMES buang noise.
        if labels_this_frame:
            self._battery_frames += 1
        else:
            self._battery_frames = 0
        self.battery_in_view = self._battery_frames >= BATTERY_PRESENT_FRAMES

        # Live vision_score reflects only labels that have persisted across
        # enough frames. SEHAT is informational, KARAT/SOBEK shape the score.
        score = 1.0
        critical_hit = False
        for label, count in self.defect_frame_counts.items():
            if count < DEFECT_PERSIST_FRAMES:
                continue
            rule = CLASS_RULES.get(label)
            if not rule:
                continue
            if rule["critical"]:
                critical_hit = True
            score += rule["delta"]
        if critical_hit:
            score = 0.0
        self.vision_score = max(0.0, min(1.0, score))

    def _process_cls(self, results):
        """Classification: kehadiran = top-1 != KOSONG (confident & persisten);
        vision_score dari kelas dominan (SEHAT/KARAT/SOBEK)."""
        probs = getattr(results[0], "probs", None) if results else None
        if probs is None:
            return
        label = self.model.names[int(probs.top1)]
        confident = float(probs.top1conf) >= CLS_CONF
        if confident and label != EMPTY_CLASS:
            self._battery_frames += 1
            self.defect_frame_counts[label] += 1
        else:
            self._battery_frames = 0
        self.battery_in_view = self._battery_frames >= BATTERY_PRESENT_FRAMES
        graded = [(l, c) for l, c in self.defect_frame_counts.items()
                  if l != EMPTY_CLASS and c >= DEFECT_PERSIST_FRAMES]
        if graded:
            self._cls_label = max(graded, key=lambda x: x[1])[0]
            self.vision_score = CLS_SCORE.get(self._cls_label, 1.0)
        else:
            self._cls_label = None
            self.vision_score = 1.0

    def get_confirmed_defects(self):
        """Defect labels that passed the per-frame persistence threshold."""
        if self.is_cls:
            return [self._cls_label] if self._cls_label in ("KARAT", "SOBEK") else []
        return sorted(
            lbl for lbl, c in self.defect_frame_counts.items()
            if c >= DEFECT_PERSIST_FRAMES
        )

    def trigger_telemetry_update(self):
        if 'on_telemetry' in self.ui_callbacks:
            self.ui_callbacks['on_telemetry']({
                "volt": self.electrical_data["volt"],
                "curr": self.electrical_data["curr"],
                "soh": self.electrical_data["soh"],
                "vision_score": self.vision_score,
                "grade": self.grade_decision or "--",
                "defects": self.get_confirmed_defects(),
            })

    def _emit_discharge_sample(self, t_ms, voltage, current, temp):
        if 'on_discharge_sample' in self.ui_callbacks:
            self.ui_callbacks['on_discharge_sample']({
                "t_ms": t_ms, "voltage": voltage, "current": current, "temp": temp,
            })

    def serial_listener(self):
        while self.running:
            line = None
            try:
                with self._serial_lock:
                    if not self.simulate and self.ser and self.ser.in_waiting > 0:
                        line = self.ser.readline().decode('utf-8', errors='ignore').strip()
            except (serial.SerialException, OSError) as e:
                # USB STM32 bisa lepas saat runtime (Errno 5). JANGAN biarkan thread
                # listener mati — itu membekukan SEMUA RX (siklus berikutnya hang
                # selamanya menunggu status). Tandai offline; _serial_watchdog reconnect.
                self.log_msg(f"[Comm] Serial read gagal ({e}) — port offline. Watchdog akan reconnect.")
                self.status["serial"] = "offline"
                self.simulate = True
                try:
                    if self.ser:
                        self.ser.close()
                except Exception:
                    pass
                self.ser = None
                self._notify_status()
                self.wait_flag = False        # jangan biarkan siklus aktif tergantung
                time.sleep(0.5)
                continue
            if line:
                self._last_rx = time.time()
                # Pulih dari status "stale": board bicara lagi.
                if self.status.get("serial") == "stale":
                    self.status["serial"] = "online"
                    self._notify_status()
                # DIAGNOSTIK sementara: lihat persis status STM32 yang masuk &
                # kapan, untuk debug urutan langkah. DISCHARGE_SAMPLE/DIAG/
                # HEARTBEAT di-skip (terlalu sering).
                if all(s not in line for s in ("DISCHARGE_SAMPLE", "DIAG", "HEARTBEAT")):
                    self.log_msg(f"[RX] {line}")
                try:
                    data = json.loads(line)
                    if data.get("status") == "MEASUREMENT_DONE":
                        v = data.get("volt", 0)
                        i = data.get("curr", 0.001)
                        t_delta = float(data.get("temp_delta", 1.0))
                        v_resting = float(data.get("v_resting", 4.2))
                        temp_pre = float(data.get("temp_pre", 25.0))
                        temp_post = float(data.get("temp_post", temp_pre + t_delta))
                        self.electrical_data["volt"] = v
                        self.electrical_data["curr"] = i
                        v_drop = v_resting - v
                        safe_i = i if i > 0 else 0.001
                        internal_r = v_drop / safe_i
                        if self.has_xgb:
                            features = pd.DataFrame(
                                [[v_drop, internal_r, t_delta]],
                                columns=['v_drop', 'internal_r', 'temp_delta'])
                            pred_soh = self.xgb_model.predict(features)[0]
                            self.electrical_data["soh"] = max(0, min(100, float(pred_soh)))
                        else:
                            self.electrical_data["soh"] = 85.0 if v > 3.6 else 40.0
                        self.measurement_detail = {
                            "v_resting": v_resting,
                            "v_loaded": v,
                            "v_drop": v_drop,
                            "current_load": i,
                            "internal_r": internal_r,
                            "temp_pre": temp_pre,
                            "temp_post": temp_post,
                            "temp_delta": t_delta,
                        }
                        self.trigger_telemetry_update()
                        self.wait_flag = False
                    elif data.get("status") == "DISCHARGE_SAMPLE":
                        t_ms = data.get("t_ms", 0)
                        v = data.get("volt", 0)
                        i = data.get("curr", 0)
                        t = data.get("temp", 0)
                        if self.current_battery_id:
                            self.logger.log_discharge_sample(
                                self.current_battery_id, t_ms, v, i, t)
                        self._emit_discharge_sample(t_ms, v, i, t)
                    elif data.get("status") in ["AT_PROX_1", "AT_PROX_2", "EJECTED_A", "DROPPED_B"]:
                        self.wait_flag = False
                    elif data.get("status") == "EMERGENCY_STOP":
                        self.log_msg("[STM32] HARDWARE EMERGENCY STOP — aborting cycle.")
                        self.abort_cycle = True
                        self.wait_flag = False
                    elif data.get("status") == "STEP_TIMEOUT":
                        self.log_msg("[STM32] STEP TIMEOUT — firmware aborted a step. Aborting cycle.")
                        self.abort_cycle = True
                        self.wait_flag = False
                        if "on_jog_end" in self.ui_callbacks:
                            self.ui_callbacks["on_jog_end"]("STEP_TIMEOUT")
                    elif data.get("status") in ("LIMIT_HIT", "JOG_STOPPED"):
                        self.log_msg(f"[STM32] {data.get('status')}")
                        if "on_jog_end" in self.ui_callbacks:
                            self.ui_callbacks["on_jog_end"](data.get("status"))
                    elif data.get("status") == "CONFIG_OK":
                        self.log_msg(f"[STM32] Calibration applied: speed={data.get('volt')} pulse={data.get('curr')}")
                    elif data.get("status") == "JOGGING":
                        self.log_msg("[STM32] Conveyor jogging (manual stop / 10 s auto-stop).")
                    elif data.get("status") == "BOOT_OK":
                        # Board (re)booted — re-push calibration so it survives a reset.
                        self.send_command("SET_CONFIG", self.calibration)
                        self.log_msg(f"[STM32] Boot detected — re-pushed calibration: {self.calibration}")
                    elif data.get("status") == "DIAG":
                        # Live diagnostic snapshot — route to panel, do not log (5 Hz).
                        if "on_diag" in self.ui_callbacks:
                            self.ui_callbacks["on_diag"](data)
                except Exception:
                    pass
            time.sleep(0.01)

    def send_command(self, cmd, params=None):
        packet = {"cmd": cmd}
        if params:
            packet.update(params)
        payload = json.dumps(packet) + '\n'
        if self.simulate:
            self.log_msg(f"[Simulate-TX] {payload.strip()}")
            if cmd == "APPLY_SENSOR_AND_MEASURE":
                self._simulate_measurement()
            self.wait_flag = False
        else:
            self.log_msg(f"[TX] {cmd}")  # DIAGNOSTIK sementara (hapus stlh debug)
            with self._serial_lock:
                if self.ser:
                    try:
                        self.ser.write(payload.encode())
                    except (serial.SerialException, OSError) as e:
                        # USB serial bisa lepas/kontak putus saat runtime (Errno 5
                        # I/O). JANGAN biarkan ini meledak ke pemanggil — kalau
                        # Emergency Stop yang memicunya, exception mengunci UI
                        # (START tak pernah di-enable lagi). Tandai offline & diam.
                        self.log_msg(f"[Comm] Serial write gagal ({e}) — port offline. Reconnect via ⚙ Serial.")
                        self.status["serial"] = "offline"
                        self.simulate = True
                        try:
                            self.ser.close()
                        except Exception:
                            pass
                        self.ser = None
                        self._notify_status()

    # ----- CALIBRATION ------------------------------------------------------
    def _load_calibration(self):
        cfg = dict(DEFAULT_CALIBRATION)
        try:
            with open(CALIB_PATH) as f:
                cfg.update({k: int(v) for k, v in json.load(f).items()
                            if k in DEFAULT_CALIBRATION})
        except Exception:
            pass  # missing/invalid file -> defaults
        return cfg

    def update_calibration(self, updates, save=True):
        """Merge *updates* into calibration (clamped per CALIB_RANGES), push the
        FULL config to the STM32, and optionally persist. Accepts any subset of
        the DEFAULT_CALIBRATION keys."""
        changed = []
        for k, v in updates.items():
            if k not in DEFAULT_CALIBRATION:
                continue
            lo, hi = CALIB_RANGES[k]
            new = max(lo, min(hi, int(v)))
            old = self.calibration.get(k)
            if old != new:
                changed.append(f"{k}:{old}->{new}")
            self.calibration[k] = new
        if changed:                       # audit trail (traceability sertifikasi)
            self.logger.log_event("CALIB_CHANGE", "; ".join(changed))
        self.send_command("SET_CONFIG", self.calibration)
        if save:
            try:
                with open(CALIB_PATH, "w") as f:
                    json.dump(self.calibration, f, indent=2)
                self.log_msg(f"[Calib] Saved {self.calibration} -> {CALIB_PATH}")
            except Exception as e:
                self.log_msg(f"[Calib] Could not save calibration: {e}")
        return self.calibration

    # Backward-compat shim (older callers passing two positional args).
    def set_calibration(self, conveyor_speed, step_pulse_us, save=True):
        return self.update_calibration(
            {"conveyor_speed": conveyor_speed, "step_pulse_us": step_pulse_us}, save)

    def jog_forward(self):
        """Run the conveyor forward continuously (setup speed test)."""
        self.send_command("JOG_FWD")

    def stop_conveyor(self):
        self.send_command("STOP_CONVEYOR")

    # ----- DIAGNOSTIC PANEL CONTROLS ---------------------------------------
    def start_diag(self):
        """Ask the STM32 to start broadcasting sensor snapshots (~5 Hz)."""
        self.send_command("START_DIAG")

    def stop_diag(self):
        self.send_command("STOP_DIAG")

    def jog_stepper(self, which, direction, steps=200):
        """Raw-jog a stepper N steps, ignoring limits. which='drain'|'sort',
        direction='fwd'|'rev'. Isolates motor/driver from limit sensors."""
        self.send_command("JOG_STEPPER",
                          {"which": which, "dir": direction, "steps": int(steps)})

    def jog_to_limit(self, which, direction):
        """Armed jog toward the limit (parallel-limit aware: release-then-hit).
        Stops at the limit, on STOP_STEPPER, or STEP_TIMEOUT. which='drain'|'sort',
        direction='fwd'|'rev'."""
        self.send_command("JOG_TO_LIMIT", {"which": which, "dir": direction})

    def stop_stepper(self):
        """Abort an in-progress jog_to_limit / home move."""
        self.send_command("STOP_STEPPER")

    def home_stepper(self, which):
        """Push a stepper to its limit then retract to home. which='drain'|'sort'."""
        self.send_command("HOME_STEPPER", {"which": which})

    def conveyor_manual(self, direction):
        """Manual conveyor: direction='fwd'|'rev'|'stop'."""
        self.send_command("CONVEYOR", {"dir": direction})

    def dac_load(self, on, value=None):
        """Manual DAC load on/off (+ optional 0-4095 value)."""
        params = {"on": 1 if on else 0}
        if value is not None:
            params["value"] = int(value)
        self.send_command("DAC_LOAD", params)

    def _simulate_measurement(self):
        """Produce a realistic measurement and a short discharge curve in --sim mode.

        Samples are emitted to the UI at the natural 20 ms cadence so the live
        plot reflects what real hardware would look like.
        """
        import random
        soh_true = random.choice([
            random.uniform(82, 98),
            random.uniform(60, 80),
            random.uniform(30, 55),
        ])
        v_resting = 4.2 - (100 - soh_true) * 0.004 + random.uniform(-0.02, 0.02)
        internal_r = 0.05 + (100 - soh_true) * 0.004 + random.uniform(-0.01, 0.01)
        current_load = 1.0
        v_loaded = v_resting - internal_r * current_load
        v_drop = v_resting - v_loaded
        temp_pre = 25.0 + random.uniform(-1, 1)
        temp_delta = 0.5 + (100 - soh_true) * 0.05 + random.uniform(-0.2, 0.2)
        temp_post = temp_pre + temp_delta

        # Stream the discharge curve in real time (20 ms cadence over ~2 s).
        samples = []
        for t_ms in range(0, 2001, 20):
            v_t = v_resting - v_drop * (1 - 2.718 ** (-t_ms / 200.0))
            temp_t = temp_pre + temp_delta * (t_ms / 2000.0)
            v_t = round(v_t, 4)
            temp_t = round(temp_t, 2)
            samples.append((t_ms, v_t, current_load, temp_t))
            self._emit_discharge_sample(t_ms, v_t, current_load, temp_t)
            if not self.running or self.abort_cycle:
                break
            time.sleep(0.02)

        if self.current_battery_id:
            self.logger.log_discharge_batch(self.current_battery_id, samples)

        self.electrical_data["volt"] = v_loaded
        self.electrical_data["curr"] = current_load
        self.measurement_detail = {
            "v_resting": v_resting,
            "v_loaded": v_loaded,
            "v_drop": v_drop,
            "current_load": current_load,
            "internal_r": internal_r,
            "temp_pre": temp_pre,
            "temp_post": temp_post,
            "temp_delta": temp_delta,
        }

        if self.has_xgb:
            features = pd.DataFrame(
                [[v_drop, internal_r, temp_delta]],
                columns=['v_drop', 'internal_r', 'temp_delta'])
            pred_soh = float(self.xgb_model.predict(features)[0])
            self.electrical_data["soh"] = max(0, min(100, pred_soh))
        else:
            self.electrical_data["soh"] = soh_true + random.uniform(-3, 3)

        # When YOLO isn't running (mock or no camera), synthesize a vision score
        # that's correlated with SOH so the demo cycle produces varied grades.
        if self.mock_ai or self.status["camera"] != "online":
            self.vision_score = max(0.0, min(1.0, 0.5 + (self.electrical_data["soh"] - 60) / 80))

        self.trigger_telemetry_update()

    def calculate_final_grade(self):
        soh = self.electrical_data.get("soh", 0)
        if self.vision_score < 0.4 or soh < 60:
            return "R"
        elif self.vision_score > 0.8 and soh > 80:
            return "A"
        else:
            return "B"

    def run_automated_cycle(self, ground_truth=None):
        self.log_msg("--- Starting Full Automated Cycle ---")
        cycle_start = time.time()
        battery_id = time.strftime("RC-%Y%m%d-%H%M%S")
        self.current_battery_id = battery_id
        self.defect_frame_counts = defaultdict(int)
        self.measurement_detail = {}
        self.abort_cycle = False  # clear any previous abort
        # Reset grade so UI shows TESTING state cleanly
        self.grade_decision = None

        # Clear any latched hardware E-stop on the STM32 so a cycle started after
        # an emergency doesn't hang on a silently-dropped command. Fire-and-forget:
        # firmware replies RESET_OK (not awaited). If the physical button is still
        # held, firmware re-enters EMERGENCY immediately.
        self.send_command("RESET")
        self._flush_serial()  # buang status basi siklus sebelumnya

        DATA_DIR.mkdir(parents=True, exist_ok=True)
        img_path = str(DATA_DIR / f"{battery_id}.jpg")

        # [1] INSPEKSI VISUAL (vision-gated). Kamera ada di HULU, menghadap bawah.
        # Jalankan konveyor, tunggu YOLO melihat baterai lewat di bawah kamera,
        # lalu STOP untuk foto diam (anti-blur) + grade. Stop ini berbasis vision
        # (toleran lag); stop presisi di stasiun ukur tetap sensor IR (langkah 2).
        self.log_msg("[1] Mencari baterai di bawah kamera…")
        self.defect_frame_counts = defaultdict(int)
        # Hanya jalankan konveyor bila baterai belum di bawah kamera (hindari lurch).
        if not self.battery_in_view:
            self.send_command("JOG_FWD")  # maju bebas (firmware auto-stop 10s pengaman)
        detected = self._wait_for_battery_in_view(timeout=8.0)
        self.send_command("STOP_CONVEYOR")
        if not detected:
            self.log_msg("[ABORT] Tidak ada baterai terdeteksi di bawah kamera (8s).")
            return
        if self._aborted():
            return
        time.sleep(0.8)                              # settle: belt berhenti, frame tajam
        self.defect_frame_counts = defaultdict(int)  # grade HANYA dari frame diam
        time.sleep(1.2)                              # akumulasi ~1.2s frame diam
        if self.latest_frame is not None:
            cv2.imwrite(img_path, self.latest_frame)
        else:
            img_path = ""
        self.log_msg(
            f"[1b] Vision: score={self.vision_score:.2f}, "
            f"defects={','.join(self.get_confirmed_defects()) or 'none'}")

        self.log_msg("[2] Moving to Sensor Station (PROX 1)...")
        self.wait_flag = True
        self.send_command("MOVE_TO_PROX_1")
        if not self._wait_for_step():
            return

        self.log_msg("[3] Pushing Sensor and Measuring...")
        self.wait_flag = True
        self.send_command("APPLY_SENSOR_AND_MEASURE")
        if not self._wait_for_step():
            return

        self.grade_decision = self.calculate_final_grade()
        self.trigger_telemetry_update()
        self.log_msg(
            f"[4] Grading Decision: {self.grade_decision} "
            f"(VS: {self.vision_score:.2f}, SOH: {self.electrical_data['soh']:.1f}%)")

        pdf_path = self.passport_gen.generate_pdf(
            battery_id=battery_id, grade=self.grade_decision,
            vision_score=self.vision_score,
            volt=self.electrical_data['volt'], curr=self.electrical_data['curr'],
            soh=self.electrical_data['soh'], image_path=img_path,
            measurement=self.measurement_detail,
            defects=self.get_confirmed_defects(),
            timestamp=time.strftime("%Y-%m-%dT%H:%M:%S"),
        )
        self.log_msg(f"[5] Battery Passport Generated: {pdf_path}")

        cycle_time = round(time.time() - cycle_start, 2)
        m = self.measurement_detail
        self.logger.log_grading(
            battery_id=battery_id,
            cycle_time_s=cycle_time,
            v_resting=round(m.get("v_resting", 0), 4),
            v_loaded=round(m.get("v_loaded", self.electrical_data["volt"]), 4),
            v_drop=round(m.get("v_drop", 0), 4),
            current_load=round(m.get("current_load", self.electrical_data["curr"]), 4),
            internal_r=round(m.get("internal_r", 0), 4),
            temp_pre=round(m.get("temp_pre", 0), 2),
            temp_post=round(m.get("temp_post", 0), 2),
            temp_delta=round(m.get("temp_delta", 0), 2),
            soh_predicted=round(self.electrical_data["soh"], 2),
            vision_score=round(self.vision_score, 3),
            defects_detected=";".join(self.get_confirmed_defects()) or "none",
            grade_predicted=self.grade_decision,
            grade_ground_truth=ground_truth or "",
            passport_pdf=pdf_path,
        )
        self.log_msg(f"[Log] Grading row appended to {self.logger.grading_path}")

        # Result is fully done & persisted here; routing below is mechanical
        # cleanup. Tell the UI now so the operator can open the passport and
        # START the next battery without waiting for (or aborting) the sort.
        if pdf_path and 'on_passport' in self.ui_callbacks:
            self.ui_callbacks['on_passport'](pdf_path, self.grade_decision)

        if self.grade_decision == "A":
            self.log_msg("[6] Routing to Grade A Bin (PROX 2)...")
            self.wait_flag = True
            self.send_command("MOVE_TO_PROX_2")
            if not self._wait_for_step():
                return

            self.log_msg("[7] Ejecting Grade A...")
            self.wait_flag = True
            self.send_command("EJECT_A")
            if not self._wait_for_step():
                return
        else:
            self.log_msg("[6] Routing to Grade B / Reject Bin (END OF CONVEYOR)...")
            self.wait_flag = True
            self.send_command("MOVE_TO_END")
            if not self._wait_for_step():
                return

        self.log_msg("--- Cycle Complete ---")

    def _aborted(self):
        if self.abort_cycle:
            self.log_msg("[ABORT] Cycle aborted by Emergency Stop.")
            return True
        return False

    def _flush_serial(self):
        """Buang status basi di buffer masuk sebelum siklus baru, agar tidak ada
        balasan lama (mis. DROPPED_B/AT_PROX dari siklus lalu) yang keliru
        meng-clear wait_flag langkah berikutnya."""
        if self.simulate:
            return
        with self._serial_lock:
            if self.ser:
                try:
                    self.ser.reset_input_buffer()
                except Exception:
                    pass

    def _wait_for_battery_in_view(self, timeout=8.0):
        """Blokir s/d kamera (hulu) melihat baterai (battery_in_view), abort, atau
        timeout. True bila terdeteksi; False bila tak ada baterai / di-abort."""
        if self.mock_ai:
            return True  # tanpa kamera nyata: lewati gating
        start = time.time()
        while self.running and not self.abort_cycle:
            if self.battery_in_view:
                return True
            if time.time() - start > timeout:
                return False
            time.sleep(0.05)
        return False

    def _wait_for_step(self, timeout=45.0):
        """Block until the firmware signals the current step is done (wait_flag
        cleared), the cycle is aborted, or `timeout` seconds elapse. Returns True
        if the step completed normally; False if it was aborted or timed out (the
        caller should stop the cycle).

        Firmware enforces its own per-step timeouts and emits STEP_TIMEOUT; this
        is a Jetson-side backstop in case that status is ever lost, so a cycle can
        never hang forever on a step that will not complete."""
        start = time.time()
        while self.wait_flag and self.running and not self.abort_cycle:
            if time.time() - start > timeout:
                self.log_msg(f"[TIMEOUT] Step exceeded {timeout:.0f}s with no response — aborting cycle.")
                self.abort_cycle = True
                self.wait_flag = False
                self.send_command("STOP_CONVEYOR")
                return False
            time.sleep(0.1)
        return not self._aborted()

    def run(self):
        threading.Thread(target=self.vision_thread, daemon=True).start()
        threading.Thread(target=self.serial_listener, daemon=True).start()
        threading.Thread(target=self._serial_watchdog, daemon=True).start()
        if not self.ui_callbacks:
            self.interactive_cli()
            self.log_msg("[System] Shutting down...")

    def _serial_watchdog(self):
        """Auto-reconnect serial USB. Field units lose the STM32 USB link
        intermittently; a write failure in send_command marks the port offline
        (simulate=True). This watchdog notices that and reconnects as soon as a
        ttyACM/ttyUSB port reappears — STOP_CONVEYOR is sent first so a board
        that was left running is brought to a safe stop on recovery."""
        while self.running:
            time.sleep(2.0)
            if not self._serial_intended:
                continue                      # launched with --sim: leave alone
            if self.ser is not None and not self.simulate:
                # Connected: deteksi board hang (port terbuka tapi MCU diam).
                # Ambang 12s > operasi blocking firmware terlama (stepper 10s)
                # agar tak false-alarm saat siklus. Self-recover saat RX masuk.
                if (self.status.get("serial") == "online"
                        and time.time() - self._last_rx > 12.0):
                    self.status["serial"] = "stale"
                    self.log_msg("[Watchdog] STM32 diam >12s (heartbeat hilang) — board mungkin hang.")
                    self._notify_status()
                continue                      # already connected
            available = [dev for dev, _ in self.list_serial_ports()]
            if not any("ACM" in d or "USB" in d for d in available):
                continue                      # no port yet — wait quietly
            port = self._pick_serial_port()
            self.log_msg(f"[Watchdog] Serial port {port} kembali — mencoba reconnect…")
            if self.reconnect_serial(port, BAUD_RATE):
                self.send_command("STOP_CONVEYOR")   # safety on recovery
                self.log_msg("[Watchdog] Reconnect sukses, konveyor di-STOP.")

    def interactive_cli(self):
        print("\n--- Hardware Test Menu ---")
        print("1: Full Automated Cycle")
        print("q: Quit")

        DATA_DIR.mkdir(parents=True, exist_ok=True)

        while self.running:
            try:
                choice = input("CMD> ").strip()
                if choice == '1':
                    threading.Thread(target=self.run_automated_cycle).start()
                elif choice.lower() == 'q':
                    self.running = False
            except EOFError:
                pass


if __name__ == "__main__":
    parser = argparse.ArgumentParser(description="RECELL-AI Controller")
    parser.add_argument('--sim', action='store_true', help='Run without STM32 connected')
    parser.add_argument('--mock-ai', action='store_true', help='Run without YOLO/Camera')
    args = parser.parse_args()

    app = RecellMaster(simulate=args.sim, mock_ai=args.mock_ai)
    app.run()
