nothinx/RECELL-AI/(commit log)

2026-05-19 feat: Shift focus to Jetson AI. Added PyQt5 dashboard, Arduino STM32 firmware, and comprehensive AI training guidelines.
2026-05-19 feat: Overhaul mechanical workflow (Prox 1, Prox 2, 2 Steppers) and implement Digital Battery Passport (PDF generation).
2026-05-19 feat: Add UI threading integration and YOLO training script for 3-day sprint
2026-05-19 docs: Add comprehensive Deployment and Flashing Guide (SSH, Jetson Setup, STM32 Arduino)
2026-05-19 perf: Maximize STM32 ADC resolution and Jetson GUI OpenGL acceleration for extreme industrial performance
2026-05-25 feat(firmware): Add WORKFLOW_TEST and STEPPER_TEST suites for manual hardware validation
    Two new STM32F411 firmware programs to validate the full sorting workflow
    end-to-end without the Jetson, plus a focused stepper verification tool.
    - STEPPER_TEST: minimal sketch with neutral-labeled "A"/"B" stepper menu
    + limit switch confirmation. Used to verify which physical pin pair
    drives which motor and which DIR level (LOW/HIGH) moves toward each
    limit switch -- run this BEFORE WORKFLOW_TEST when wiring changes.
    - WORKFLOW_TEST: full sort cycle driven step-by-step from serial. One
    cycle = conveyor->IR1 (auto), stepper drain push to limit (Enter),
    SoH measurement (Enter, identical profi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
2026-05-26 feat(ai): Train XGBoost SOH model on NASA cleaned dataset
    Replace mock-data skeleton with end-to-end Colab notebook (kagglehub
    download of patrickfleith/nasa-battery-dataset, Leave-One-Battery-Out CV
    on B0005/06/07/18, export to soh_xgb_model.json). Includes trained
    200-tree model drop-in compatible with main.py:55, plus design spec
    under docs/superpowers/specs/.
2026-05-27 feat(firmware): Migrate to final pinout (BTS7960 + I2C sensors) and add HARDWARE_TEST suite
    Rewires STM32F411 to the confirmed production pinout: BTS7960 motor driver for
    conveyor (EN/RPWM/LPWM), I2C bus for INA226 (V/I), MLX90614 (laser temp), and
    MCP4725 DAC for constant-current load. Adds limit switches, IR sensors, and
    emergency stop with active-low handling. Updates STEPPER_TEST pin assignments
    to match, and introduces HARDWARE_TEST as a unified manual validation sketch.
    [Pin Out Baterai BANZAIIIII - Konfirmasi Pinout Final Sistem.csv]
2026-05-27 feat(jetson): Add CLI flags for dashboard sim/mock-ai modes and harden SOH calc
    Replaces the hardcoded simulate=True / mock_ai=True with --sim and --mock-ai
    argparse flags so the dashboard can switch between dev simulation and live
    hardware without code edits. Guards the internal-resistance calculation against
    ZeroDivisionError when measured current is zero, and now reads temp_delta from
    the STM32 telemetry payload instead of using a hardcoded placeholder.
    Adds matplotlib and seaborn to requirements for paper/poster plotting.
    [main.py, ui_dashboard.py]
2026-05-27 feat(jetson): Add DataLogger for grading session CSVs and wire into automated cycle
    Adds jetson/src/data_logger.py with two-file schema: grading_log.csv (one row per
    battery with electrical metrics, vision score, defects, predicted vs ground-truth
    grade) and discharge_curve.csv (time-series samples captured during the
    constant-current load test). Both files share battery_id for join.
    RecellMaster now logs an aggregate row at the end of every cycle and forwards
    STM32 DISCHARGE_SAMPLE events to the time-series CSV. The --sim path produces
    a realistic 2-second exponential discharge curve so the logging pipeline is
    exercised end-to-end without hardware.
2026-05-27 feat(research): Add dataset simulator and expand paper visuals to 5 plots
    Introduces simulate_dataset.py which produces synthetic grading_log.csv and
    discharge_curve.csv in the exact schema that the live machine writes, so the
    paper visualisation pipeline can be exercised before hardware is collecting
    real data. Distribution is tuned to include fusion-critical edge cases
    (electrically healthy but visually defective cells) so the AI fusion scatter
    plot has off-quadrant points that motivate the multimodal claim.
    generate_graphs.py is rewritten to consume the new CSV schema and now emits
    five 300 DPI figures: grade distribution, fusion scatter with decision
    boundaries, empirical discharge curv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
    [discharge_curve.csv, grading_log.csv]
2026-05-28 feat(jetson): Integrate trained YOLO best.pt and ship polished light-theme HMI
    - Wire jetson/models/weights/best.pt (KARAT/SEHAT/SOBEK) into RecellMaster
    with auto-fallback engine→pt and graceful mock-AI mode
    - Anchor all paths to BASE_DIR via pathlib so cwd doesn't matter
    - Add camera isOpened() guard + try/finally cap.release(); throttle
    vision_thread to ~25 FPS to keep dev-box CPU sane
    - Replace defects_seen set with per-frame counter + DEFECT_PERSIST_FRAMES=3
    threshold so single false positives no longer permanently mark a battery
    - Make Emergency Stop actually abort: abort_cycle flag breaks every wait
    loop in run_automated_cycle and _simulate_measurement
    - Stream discharge sam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
    [main.py, ui_dashboard.py]
2026-06-08 feat(firmware): Add oscillate 2-limit diagnostic and live speed control to STEPPER_TEST
    - New 'oscillate' mode (menu 9 / m) bounces each stepper between its two
    paralleled limit switches using armed + re-arm debounce, confirming both
    end limits exist on one pin.
    - Live PULSE_US tuning via +/- keys (40-800us) to find safe step rate.
    - README updated with new menu options and dual-limit notes.
    [STEPPER_TEST.ino]
2026-06-08 feat(firmware): Add AUTO threshold mode and fix sorting stepper return-to-home in WORKFLOW_TEST
    - Sorting ejector (stepper 2) now retracts until it hits the HOME limit
    (mirrors drain), instead of a fixed 2500 steps. Fixes ejector stopping
    short of home / drifting each cycle when the forward throw exceeds 2500.
    - Removed now-dead STEPPER_RETRACT_SORT constant and moveStepperSteps helper.
    - AUTO / AUTO n mode: full cycle with no ENTER gates; grade decided from
    v_load vs GRADE_A_MIN_V threshold (grade_source=AUTO_THRESH).
    - Richer SoH logging: v_open_V and r_internal_mOhm; per-step sensor snapshots;
    mode + grade_source CSV columns. Grade decision moved to STEP 5 (after
    measure + retra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
    [WORKFLOW_TEST.ino]
2026-06-08 fix(protocol): Sync STM32 measurement telemetry with Jetson parser
    Jetson (master) expected fields the STM32 never sent, silently degrading
    the SoH pipeline and hanging on hardware E-stop. Bring them in sync:
    STM32 (RECELL_STM32):
    - APPLY_SENSOR_AND_MEASURE now reads open-circuit voltage (v_resting) and
    temp_pre BEFORE applying the DAC load, so Jetson's v_drop / internal_R /
    XGBoost SoH features use real data instead of the hardcoded 4.2 V default.
    - Streams ~40 DISCHARGE_SAMPLE points over the 2s load (new sendDischargeSample)
    so the live discharge curve works on real hardware, not just --sim.
    - MEASUREMENT_DONE now includes v_resting, temp_pre, temp_post via new
    sendMeasurement();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
    [RECELL_STM32.ino, main.py]
2026-06-08 refactor(firmware): Semua gerakan stepper produksi sampai limit switch
    Sebelumnya RECELL_STM32 retract pakai step tetap (drain 1000, sort 2500)
    karena moveStepperUntilLimit versi lama langsung break saat limit LOW ->
    tidak bisa mundur dari posisi menempel limit (berhenti di ~0 step).
    - moveStepperUntilLimit kini robust: arming + release-confirm debounce +
    konfirmasi limit anti-noise + abort EMERGENCY + ceiling STEPPER_MAX_STEPS
    (pengaman bila limit gagal, stepper tak jalan tak terbatas). Tetap senyap
    (tanpa Serial.print) karena Serial = kanal JSON ke Jetson.
    - Hapus helper moveStepper (step tetap). Drain retract & ejector retract kini
    mundur SAMPAI limit home (DIR LOW) -> posisi hom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
    [RECELL_STM32.ino]
2026-06-15 docs(specs): Firmware v2 (Jetson-master) + offline air-gapped deploy design
    Spec A: tulis ulang RECELL_STM32.ino pakai mekanik WORKFLOW_TEST yang
    teruji (pin/arah DIR/return-to-home/debounce limit), protokol JSON GUI
    tidak berubah, plus auto-RESET tiap siklus untuk pulih dari E-stop.
    Spec B: deployment air-gapped ke Jetson Orin Nano Super via wheelhouse
    aarch64 + scp dari laptop, requirements runtime minimal, install offline.
2026-06-15 test(protocol): add Jetson<->STM32 contract sync regression
2026-06-15 feat(firmware): rewrite production firmware on WORKFLOW_TEST mechanics
    Adopsi pin terkoreksi, DIR LOW=maju, return-to-home + debounce limit tanpa
    ceiling, init INA226 setResistorRange (perbaiki pembacaan arus), measurement
    abort-aware terhadap E-stop. Protokol JSON tidak berubah.
2026-06-15 fix(jetson): send RESET at cycle start to recover from hardware E-stop
    [main.py]
2026-06-15 docs(deploy): offline air-gapped Jetson deployment guide + runtime deps (Spec B)
    - requirements-jetson-runtime.txt: dependency runtime ramping (tanpa MQTT/
    cloud/FastAPI), torch/torchvision dari index jetson-ai-lab terpisah.
    - setup.sh: install offline dari wheelhouse (--no-index), venv
    --system-site-packages, verifikasi CUDA.
    - DEPLOY_GUIDE_RECELL.md: tulis ulang untuk Jetson Orin Nano Super air-gapped
    (JetPack 6) — staging wheel aarch64 di laptop, transfer scp dari Windows,
    install offline, flashing STM32 v2, autostart, troubleshooting.
2026-06-15 feat(reliability): per-step timeouts to prevent cycle hangs
    Firmware: moveStepperUntilLimit kini return bool dgn stall-guard 10s; bila
    limit tak kunjung kena -> emit STEP_TIMEOUT, mesin balik IDLE. WAIT_PROX_1/2
    dapat timeout 25s (baterai nyangkut / IR rusak) -> STEP_TIMEOUT.
    Jetson: helper _wait_for_step (backstop 45s) menggantikan 5 loop tunggu tak
    terbatas; tangani status STEP_TIMEOUT -> abort siklus rapi + log. Siklus tak
    bisa lagi hang selamanya pada langkah yang tak akan selesai.
    Test kontrak diperluas dgn STEP_TIMEOUT.
    [RECELL_STM32.ino, main.py]
2026-06-15 fix(passport): WinAnsi-safe ohm unit, add Pillow for photo, key warning+chmod
    Review opus: 'Ω' (U+03A9) tak ada di encoding font bawaan reportlab -> ganti
    'Ohm'. drawImage JPEG butuh Pillow -> tambah ke requirements. load_or_create_key
    kini log peringatan + chmod 600 saat membuat kunci.
    [passport_auth.py, passport_generator.py]
2026-06-17 docs(readme): tambah section passport bertanda tangan & protokol firmware↔GUI
    - Section anti-pemalsuan Battery Passport (HMAC-SHA256 + QR + verifier offline)
    - Section protokol sinkronisasi Jetson↔STM32 (command, status, skema field JSON)
    - Update diagram arsitektur, cycle, tabel output, dan status verifikasi
2026-06-17 fix(ui): kontras WCAG untuk nilai headline + xgboost import opsional
    UI (ui_dashboard.py):
    - Tambah token teks gelap (-700) terpisah dari warna fill (-500). Nilai
    headline (grade, voltage, SOH, current) tadinya pakai Tailwind-500 sebagai
    teks di latar terang dan gagal kontras (~2.1-2.5:1); kini 4.8-5.9:1.
    - MetricCard: pisah warna dot (terang) dari warna nilai (gelap, terbaca).
    - GRADE A/B/R, state TESTING/ABORTED, dan teks tombol START disabled ikut
    digelapkan. Dot status & background fill tetap -500.
    main.py:
    - import xgboost jadi opsional; tanpa xgboost app tetap jalan dengan SOH
    rule-based, bukan crash di import. Diverifikasi via smoke-test + import
    test dengan xgboost dibloki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
    [main.py, ui_dashboard.py]
2026-06-17 feat(deploy): skrip deploy laptop->Jetson + systemd service autostart
    deploy/deploy.sh (baru, jalan di laptop):
    - setup SSH key sekali (password Jetson tak disimpan), transfer proyek +
    wheelhouse via tar-over-ssh (artefak di-exclude), lalu run setup.sh.
    setup.sh:
    - pasang & enable systemd service 'recell' (GUI di HDMI saat boot:
    graphical.target + DISPLAY=:0 + XAUTHORITY), tambah user ke grup dialout
    untuk akses /dev/ttyUSB0. Lewati dengan --no-service.
    docs/DEPLOY_GUIDE_RECELL.md: section '0. Cara cepat' + selaras blok service.
    .gitattributes: paksa LF untuk *.sh agar skrip tak rusak di clone Windows.
2026-06-17 fix(deploy): air-gapped Jetson — matikan ultralytics telemetry + laptop prepare script
    - main.py: disable ultralytics sync/telemetry sebelum YOLO init (cegah HTTP timeout di Jetson air-gapped)
    - setup.sh: persist settings.update({'sync': False}) ke Ultralytics settings file; pre-install onnx/onnxslim dari wheelhouse agar yolo export format=engine bisa offline
    - laptop/prepare.sh: skrip baru untuk membangun wheelhouse di laptop (online) — pip download aarch64/cp310, cek checklist, panduan unduh manual torch/onnxruntime-gpu
    - docs: label [LAPTOP — ONLINE] / [JETSON — OFFLINE] di setiap tahap deploy; tambah onnxruntime-gpu ke daftar unduh manual; troubleshooting YOLO telemetry & yolo ex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
    [main.py]
2026-06-17 fix(deps): hapus PyQt5 & opencv dari pip requirements — pakai sistem JetPack
    PyQt5 tidak punya wheel aarch64 di PyPI (error saat pip download).
    opencv-python-headless dari PyPI versi CPU-only, akan menimpa cv2 CUDA JetPack.
    Keduanya tersedia sebagai paket sistem JetPack dan aksesibel via --system-site-packages.
2026-06-17 fix(deps): hapus fpdf dari requirements — tidak ada wheel PyPI, tidak dipakai
    fpdf hanya sdist di PyPI (pip download --only-binary gagal). PDF passport
    sepenuhnya ditangani reportlab; fpdf tidak diimport di mana pun.
2026-06-17 feat(deploy): tambah mode --online di setup.sh + panduan deploy online
    setup.sh sekarang mendukung dua mode:
    bash setup.sh → offline (dari wheelhouse/, tanpa internet)
    bash setup.sh --online → online (pip install langsung + index jetson-ai-lab)
    DEPLOY_GUIDE_ONLINE.md: panduan baru untuk Jetson yang ada internet —
    cukup git clone + bash setup.sh --online, tidak perlu wheelhouse atau scp.
2026-06-18 fix(deps): tambah scikit-learn + fix numpy konflik + fullscreen + serial config UI
    - Tambah scikit-learn ke requirements (dibutuhkan xgboost.XGBRegressor)
    - Downgrade numpy ke <2 agar kompatibel dengan scipy sistem JetPack
    - Hapus opencv-python dari pip (bawa Qt plugin konflik) — pakai cv2 JetPack
    - Perbaiki XAUTHORITY di service → /run/user/1001/gdm/Xauthority
    - Tambah flag --fullscreen: X11BypassWindowManagerHint + match screen geometry
    - Kurangi minimum widget size agar muat di 1366×768
    - Tambah SerialConfigDialog: scan port, pilih, connect/disconnect dari UI
    - STM32 pill di header kini clickable → buka dialog konfigurasi serial
    - Tambah RecellMaster.reconnect_serial() dan disconne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
    [main.py, ui_dashboard.py]
2026-06-18 feat(ui): async YOLO init + jam digital + counter baterai sesi
    - YOLO & hardware init dipindah ke background thread → window muncul
    dalam ~8 detik, bukan 35 detik (layar beku saat boot)
    - Tambah UIBridge.init_done_signal untuk handoff bg→main thread yang aman
    - Guard trigger_cycle / trigger_stop / serial_config / closeEvent jika
    master belum siap (self.master is None)
    - Jam digital HH:MM:SS + tanggal update tiap detik via QTimer di header
    - Counter "Baterai Sesi Ini" di header, increment tiap cycle selesai
    Claude-Session: https://claude.ai/code/session_01C9Wyoqm6DzmErJ5hkzhx9R
    [ui_dashboard.py]
2026-06-18 feat: selesaikan semua item backlog UX & reliability
    #4 Passport PDF — tombol "Buka Passport" aktif setelah siklus selesai,
    dibuka via xdg-open; on_passport callback dari RecellMaster ke UI
    #5 Serial lock — threading.Lock() membungkus semua akses self.ser di
    serial_listener, send_command, reconnect_serial, disconnect_serial
    #6 XAUTHORITY — hapus hardcode UID 1001, pakai systemd specifier %U
    agar service tetap bekerja jika user/UID berubah
    #7 Override grade — tombol A/B/R muncul setelah siklus selesai;
    RecellMaster.override_grade() update grade + trigger telemetry
    #8 Camera reconnect — klik pill CAMERA memanggil restart_camera();
    vision_thread dibagi jadi loop + _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
2026-06-22 feat: runtime motion calibration panel + slower defaults, ship new YOLO model
    Trial showed the conveyor over-shooting the IR sensor even at PWM 30. Make
    motion speed tunable live instead of hardcoded constants:
    - firmware: CONVEYOR_SPEED/STEPPER_PULSE_US -> runtime vars conveyorSpeed (25)
    + stepPulseUs (50); add SET_CONFIG + JOG_FWD serial commands
    - main.py: load/save calibration.json, push SET_CONFIG to STM32 on connect and
    on reconnect (outside serial lock to avoid deadlock), jog/stop helpers
    - ui_dashboard.py: CalibrationDialog (speed/pulse + live jog test), opened by
    on-screen KALIBRASI button and F12
    - models: install retrained best.pt (classes KARAT/SEHAT/SOBEK unchanged)
    - doc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
    [RECELL_STM32.ino, main.py, ui_dashboard.py]
2026-06-22 feat(research): poster figure generator, doc builder, and generated assets
    Add build_poster_doc.py + generate_poster_figures.py, expand simulate_dataset.py,
    and commit generated poster data/figures (fig1-7).
    Claude-Session: https://claude.ai/code/session_01NVo6g8yCxWdLeAfgnLSgBo
    [discharge_curve.csv, grading_log.csv]
2026-06-22 feat: harden calibration — jog auto-stop, status logging, gitignore calib
    Follow-up robustness fixes:
    - firmware: JOG_FWD auto-stops after 10 s (JOG_TIMEOUT_MS) so a forgotten jog
    can't run the conveyor forever; timer cleared by any normal move/stop
    - main.py: log CONFIG_OK/JOGGING from STM32, and re-push calibration on BOOT_OK
    so a board reset re-applies tuned values even without a Jetson reconnect
    - gitignore jetson/calibration.json (per-machine tuning, not for the repo)
    - docs: note the 10 s jog auto-stop
    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
    [RECELL_STM32.ino, main.py]
2026-06-22 chore: track calibration.json as a backup of device tuning
    Single-machine deployment, so commit calibration.json (baseline 25/50) instead
    of ignoring it — re-flashing or re-cloning the Jetson restores tuning without
    recalibrating. After tuning on the device, commit the updated file to back it up.
    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
2026-06-22 feat: conveyor soft-start + show active calibration in UI
    - firmware: startConveyorForward ramps PWM 0->target (~15ms/step, ~300ms @ 100)
    so the belt doesn't jerk and the battery doesn't over-shoot the IR sensor;
    ramp aborts cleanly on E-stop
    - ui_dashboard: Conveyor Control card shows live "Kalibrasi: speed N · pulse N µs",
    refreshed on boot and after the calibration dialog closes
    - docs: note soft-start + active-value readout
    Skipped per-station speed/pulse knobs (YAGNI until a trial proves one value
    insufficient).
    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
    [RECELL_STM32.ino, ui_dashboard.py]
2026-06-22 docs: add field trial checklist
    Step-by-step pre-flight + cycle + safety + tuning-backup checklist for testing
    on real Jetson+STM32 hardware.
    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
2026-06-22 fix: STM32 on ttyACM0 + realtime vision optimizations
    - serial: default /dev/ttyACM0 (STM32 USB CDC, not ttyUSB0) with auto-detect
    across ACM/USB candidates via _pick_serial_port()
    - vision realtime: cap buffersize 1 (kills perceived lag from stale frames),
    capture at 640x480, infer at imgsz=320 conf=0.25, drop artificial FPS cap
    - docs: ttyACM0 note + troubleshooting rows for lag and single-class detection
    Note: "only SOBEK detected" is a model/training issue (class imbalance / camera
    domain shift), tunable via YOLO_CONF but not fully fixable in code.
    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
    [main.py]
2026-06-22 feat(jetson): one-command TensorRT export script
    export_tensorrt.sh: activates venv, exports best.pt -> best.engine at
    imgsz=320 half=True (matches main.py inference), verifies output. Must run on
    the Jetson — the engine is GPU/JetPack/TensorRT-specific and not portable.
    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
2026-06-22 fix(jetson): GPU preflight in export script + torch-wheel troubleshooting
    The Jetson had a generic torch wheel (+cu130) incompatible with its CUDA 12.2
    driver, so cuda.is_available()=False — TensorRT export fails and inference runs
    on CPU (the real cause of the lag). Add a clear preflight check to the export
    script and a troubleshooting row with the Jetson torch wheel fix.
    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
2026-06-22 docs: fix dead jetson-ai-lab domain (.dev->.io) + JetPack 6.2 upgrade guide
    - jetson-ai-lab.dev is dead (DNS fail); migrated all refs to .io
    - document that cu126 wheels need JetPack 6.2 (CUDA 12.6 + cuDNN 9); cu122 index
    removed, so JP6.0 must upgrade first — add full apt upgrade + reinstall steps
    (root cause of the libcudnn.so.9 import error)
    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
2026-06-23 feat: hardware diagnostic/calibration panel + field robustness fixes
    Panel diagnostik (perlu reflash STM32):
    - Firmware: ramp akselerasi stepper (fix STEP_TIMEOUT/stall), broadcast DIAG
    sensor live (~5Hz), command JOG_STEPPER/HOME_STEPPER/CONVEYOR/DAC_LOAD/
    START_DIAG, parameter tunable DAC load + discharge + IR2 settle
    - Jetson: skema kalibrasi 8-field, routing DIAG, method kontrol aktuator
    - UI: dialog kalibrasi ber-tab (Monitor/Parameter/Manual) + indikator sensor live
    Robustness (sudah deploy, tanpa reflash):
    - send_command menelan error serial write (Errno 5) -> USB lepas tak lagi
    mengunci UI setelah Emergency Stop
    - Emergency Stop otoritatif: langsung re-enable START (tak menung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
    [RECELL_STM32.ino, main.py, ui_dashboard.py]
2026-06-23 feat(jetson): serial USB auto-reconnect watchdog
    Field units drop the STM32 USB link intermittently (3x in one session). A
    write failure now marks the port offline; this watchdog reconnects as soon as
    a ttyACM/ttyUSB port reappears and sends STOP_CONVEYOR on recovery so a board
    left running is brought to a safe stop. No manual restart needed.
    Claude-Session: https://claude.ai/code/session_01KTwGDH7b4VZ7UQaw7ufqeq
    [main.py]
2026-06-23 feat: production features — stats dashboard, USB export, audit trail, interlock, heartbeat
    Membuat HMI lebih production-grade (skip fitur YAGNI: multi-user/i18n/DB/refactor):
    - Dashboard statistik produksi (StatsDialog): hitungan hari ini/total, distribusi
    grade A/B/R, rata-rata waktu siklus — baca agregat dari grading_log.csv.
    - Export semua log + passport ke USB flashdisk (deteksi /media, satu tombol).
    - Audit trail operator (events_log.csv): perubahan kalibrasi & override grade
    dicatat dgn timestamp untuk traceability.
    - Start interlock: tolak START bila STM32 offline/sim (cegah perintah tertelan).
    - STM32 heartbeat ~1Hz + deteksi staleness Jetson (board hang vs kabel lepas;
    pil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
    [RECELL_STM32.ino, data_logger.py, main.py, ui_dashboard.py]
2026-06-23 feat(ui): Ctrl+Q quit with confirmation in fullscreen kiosk
    Frameless fullscreen mode had no OS close button and keyPressEvent only
    handled F12, leaving no way to exit the app from the GUI. Add Ctrl+Q ->
    confirm dialog -> close() (closeEvent stops the master).
2026-06-23 chore(calib): set field-tuned conveyor_speed 20 (was 25)
    Field trial lowered conveyor speed to 20 to stop IR overshoot. Bake the
    tuned value into the tracked backup so a fresh deploy starts correct.
2026-06-23 feat(calib): jog-to-limit toggle for steppers (arm-aware, stoppable)
    Manual tab jog used fixed-N raw steps (jogStepperRaw) that ignore limits —
    hard to drive a carriage to its end and confusing to use. Add a toggle that
    runs the stepper until the limit switch, handling the parallel-wired limits
    correctly (release-then-hit arming, already in moveStepperUntilLimit).
    - firmware: JOG_TO_LIMIT command (one-direction moveStepperUntilLimit, no
    auto-retract) emitting LIMIT_HIT; STOP_STEPPER + an in-loop serial STOP
    poll so a move aborts mid-flight (emits JOG_STOPPED); Serial.setTimeout
    bounds the poll read.
    - jetson: jog_to_limit()/stop_stepper(); route LIMIT_HIT/JOG_STOPPED and
    STEP_TIME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
    [RECELL_STM32.ino, main.py, ui_dashboard.py]
2026-06-23 fix(jetson): survive USB drop in serial_listener (was killing RX thread)
    A mid-runtime USB drop raised OSError [Errno 5] on ser.in_waiting inside
    serial_listener; uncaught, it killed the reader thread, so no further RX was
    processed and the next cycle hung forever at _wait_for_step ("only one cycle"
    then stuck). Catch SerialException/OSError like send_command does: mark the
    port offline, clear wait_flag so an active cycle unblocks, and let the
    watchdog reconnect — the listener loop keeps running.
    [main.py]
2026-06-23 feat(vision): dataset capture + Roboflow upload tooling for retraining
    The shipped YOLO model is domain-shifted (often only detects SOBEK). Add the
    two pieces missing to retrain on real-rig data:
    - capture_dataset.py: grab JPGs from the camera with the SAME settings as the
    app (848x480, MJPG, focus 115) so the dataset matches the inference domain.
    Headless auto-interval (works over SSH) or --preview keypress. Stop the
    recell service first (camera contention).
    - upload_roboflow.py: push the image folder to a Roboflow project via the
    roboflow SDK (annotate in web; classes KARAT/SEHAT/SOBEK).
    Training reuses existing train_yolo.py / Train_YOLOv8.ipynb (Colab), then
    export_tensorrt.sh on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
2026-06-23 feat(vision): burst capture mode + Roboflow key-file fallback
    capture_dataset.py: default mode now ENTER-triggered burst of --burst frames
    (reposition the battery between triggers); --auto interval and --preview kept.
    upload_roboflow.py: read API key from gitignored jetson/.roboflow_key if env
    ROBOFLOW_API_KEY unset. Key file is gitignored (never committed).
2026-06-23 feat(vision): GUI dataset capture (single-label, folder-per-class)
    PyQt5 capture tool for a non-technical helper: pick class (KOSONG/SEHAT/
    KARAT/SOBEK), press AMBIL -> burst saved into datasets/capture/<class>/ —
    auto-labeled by folder, no separate annotation step. Live preview + per-class
    counters. Reuses capture_dataset camera setup (848x480/MJPG/focus115).
2026-06-23 feat(vision): Colab YOLOv8-cls training notebook + Roboflow defaults
    Train_YOLOv8_cls.ipynb: Roboflow(folder) -> yolov8n-cls train on Colab GPU ->
    download best.pt -> TensorRT on Jetson. API key via Colab Secrets (not stored
    in the file). upload_roboflow.py: default workspace/project (legacy-gyzej/
    baterai-legacy).
2026-06-23 feat(vision): cross-platform capture (Windows DSHOW + OpenCV focus lock)
    Capture can run on a Windows laptop (just move the camera USB; rig position/
    lighting unchanged = same domain). v4l2-ctl is Linux-only, so: pick CAP_DSHOW
    on Windows for reliable property control, and lock focus via OpenCV props
    (AUTOFOCUS off + FOCUS) instead of v4l2-ctl. lock_focus now takes the cap.
2026-06-23 feat(vision): in-GUI Roboflow upload button + camera switcher
    capture_gui.py: '⬆ Upload ke Roboflow' button runs upload_roboflow.py via an
    isolated .venv_rf (QProcess, background) so roboflow's deps never touch the
    GUI's cv2; camera-index switcher (0/1/2) to pick USB rig cam vs laptop webcam.
    upload_roboflow.py: per-class folder upload — subfolder name becomes the
    classification label (annotation_path=classname, confirmed in roboflow SDK).
    .venv_rf gitignored.
2026-06-23 feat(vision): auto-select USB rig camera by DShow name (avoid built-in)
    --index now defaults to -1 = auto: on Windows, pick the camera whose DShow
    name matches the rig (Logitech/C930e) instead of the built-in webcam, via
    pygrabber. Falls back to index 0 if pygrabber missing or no match. GUI Cam
    0/1/2 buttons still allow manual override.
2026-06-23 feat(vision): classification pipeline (KOSONG/SEHAT/KARAT/SOBEK)
    Switch camera AI from detection to a classifier (best_cls.pt, yolov8n-cls).
    Model load now prefers best_cls.engine/best_cls.pt (task=classify), falls back
    to the old detection model. New _process_cls: presence = top-1 != KOSONG
    (confident + persistent) so the camera gate no longer needs IR (none under the
    camera); vision_score from the dominant class (SEHAT=1.0, KARAT=0.5, SOBEK=0.0)
    feeds the existing calculate_final_grade. imgsz 224 for cls. get_confirmed_defects
    returns the dominant KARAT/SOBEK class. Detection path kept as fallback.
    [main.py]
2026-06-24 fix(firmware): MCP4725 DAC address 0x62->0x60 (matches I2C scan); rename RECELL_STM32 sketch to main
    [HARDWARE_TEST.ino, WORKFLOW_TEST.ino, main.ino]
2026-06-26 feat(ui): free START during sort, preemptive restart, dual-axis discharge plot
    - Show passport & re-enable START as soon as the grade is persisted, before
    the mechanical sort/eject finishes — operator no longer locked out for the
    routing window (kills the "E-stop to restart" workaround).
    - START now preempts a still-running prior cycle (abort + join) instead of
    refusing, folding "E-stop then START" into START itself.
    - Allow START in --sim mode (commands are simulated); only reject real
    "offline" serial.
    - Current gets its own right-hand axis/viewbox so the flat ~1 A line stops
    squashing the voltage discharge curve; colour-coded axis labels replace the
    overlapping legend.
    - Min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
    [main.py, ui_dashboard.py]
2026-06-29 feat(carollus): self-contained computer vision module (4-class classifier)
    Modul vision mandiri untuk grading kondisi fisik baterai 18650:
    classifier YOLOv8n-cls 4 kelas (KARAT/KOSONG/SEHAT/SOBEK), skrip
    export ONNX, deploy (ONNX & PyTorch), evaluasi, sample images, dan
    laporan. Tambah carollus ke tabel workspace di README utama.
